TheKingOfChaos/RF-UPS-Monitor/docs/diagrams/README.md

# Diagrams

Excalidraw diagrams of the project. Each `.excalidraw` file opens and edits at [excalidraw.com](https://excalidraw.com) (Open, or drag the file in) or in VS Code with the Excalidraw extension; the `.svg` next to it is the exported picture used in the docs.

| Diagram | Shows | Used in |
|---|---|---|
| [system-overview](system-overview.svg) | Mains side, board (Pico, W5500, flash, button, LED), PC and network | README |
| [firmware-architecture](firmware-architecture.svg) | `src/`, the pure and hardware libraries in `lib/`, the Arduino-Pico core | README, project structure |
| [snmp-request-flow](snmp-request-flow.svg) | Size check, rate limiter, parsing, version and community checks, MIB, response, auth-failure trap | README, SNMP |
| [mains-flow](mains-flow.svg) | GPIO27 sampling and debouncing on core 1, seqlock, status/SNMP/traps on core 0, LibreNMS; the reset button path | README, mains monitoring |
| [settings-storage](settings-storage.svg) | Saving to the A/B slots and choosing a copy at boot | README, settings storage |
| [test-layers](test-layers.svg) | Native, sanitizer, net-snmp, on-device, HIL, mains and LibreNMS tests, and what CI runs | docs/TESTING.md |
| [web-request-flow](web-request-flow.svg) | Web page: request reading, login and lockout, sessions, CSRF check, validation, save | README, web page |
| [network-addresses](network-addresses.svg) | Where the IPv4 and IPv6 addresses, the IPv6 gateway and the trap destination come from | README, IPv6 |

## Changing a diagram

The `.excalidraw` files are generated by [make_diagrams.py](make_diagrams.py), which places the boxes and binds the arrows to them. Either edit the script and regenerate, or edit a file in Excalidraw; regenerating overwrites hand edits, so pick one.

```powershell
python docs/diagrams/make_diagrams.py                 # .excalidraw files
wsl -d Ubuntu-24.04 -- bash docs/diagrams/render_svg.sh   # .svg files (needs Docker and internet)
```

`render_svg.sh` runs [render.mjs](render.mjs) in the Playwright Docker image: headless Chromium loads Excalidraw 0.17.6 and exports each file with Excalidraw's own `exportToSvg`, then the hand-drawn Virgil font is embedded so the SVGs look the same on GitHub. After editing a diagram in Excalidraw, run only `render_svg.sh`, or export the SVG from Excalidraw yourself (Export image → SVG, with "Embed scene" off).
