TheKingOfChaos/RF-UPS-Monitor/hardware/pico-poe-mains-carrier/images/bottom.png

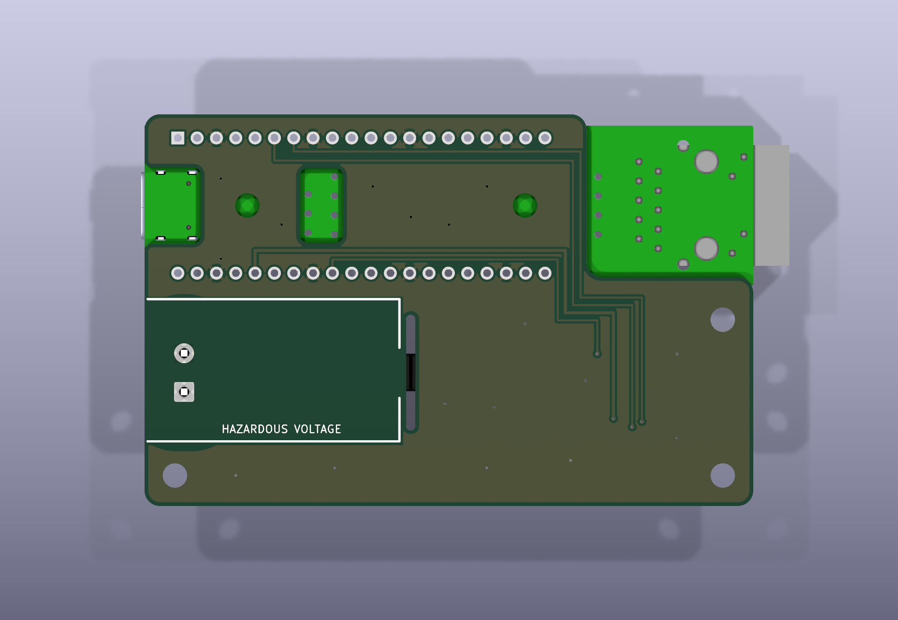
hardware/pico-poe-mains-carrier/images/bottom.png
