TheKingOfChaos/RF-UPS-Monitor/hardware/pico-poe-mains-carrier/images/iso-back-headers.png

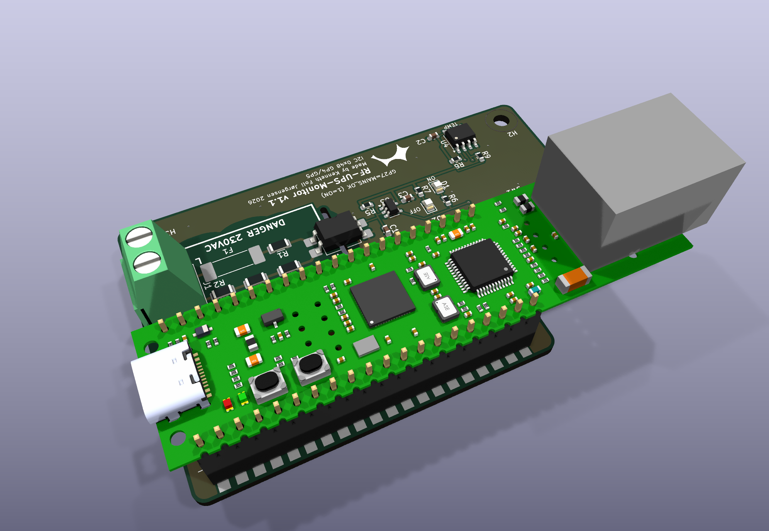
hardware/pico-poe-mains-carrier/images/iso-back-headers.png
