TheKingOfChaos/RF-UPS-Monitor/hardware/pico-poe-mains-carrier/images/top-carrier-only.png

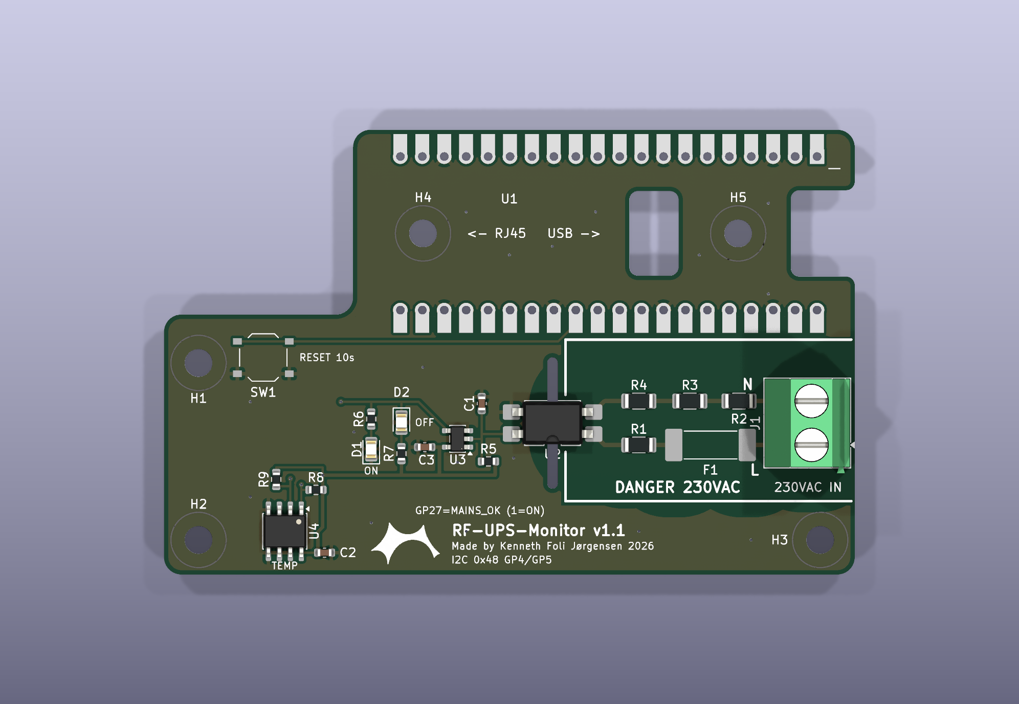
hardware/pico-poe-mains-carrier/images/top-carrier-only.png
