TheKingOfChaos/RF-UPS-Monitor/hardware/pico-poe-mains-carrier/images/top.png

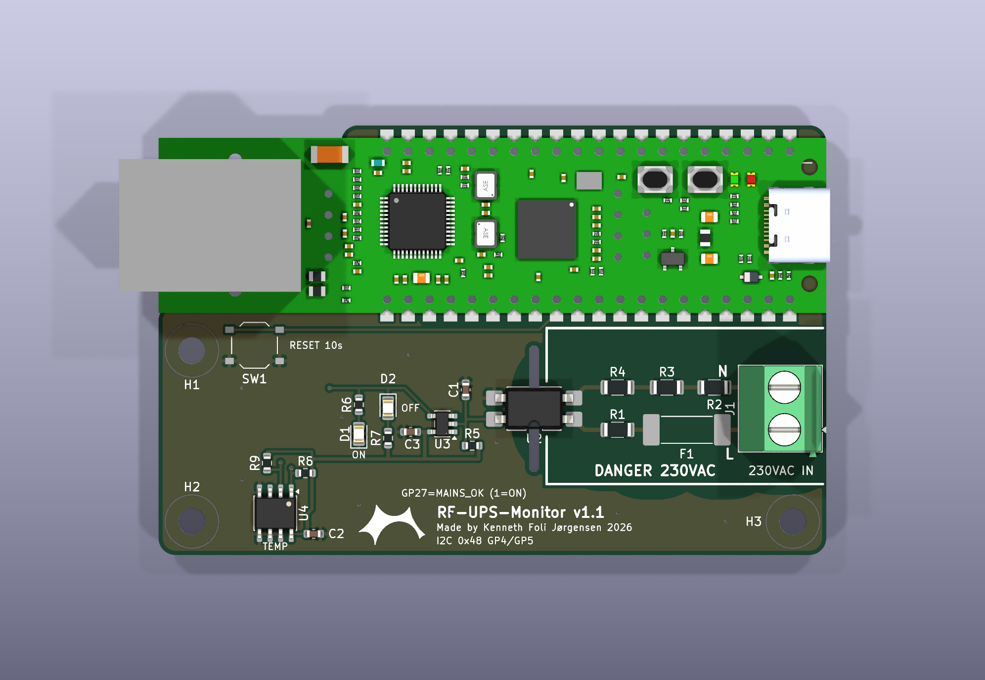
hardware/pico-poe-mains-carrier/images/top.png
