TheKingOfChaos/RF-UPS-Monitor/hardware/pico-poe-mains-carrier/fab/pico-poe-mains-carrier-bom.csv

Designator | Comment | Footprint | LCSC Part # | MPN | Quantity
C1 | 1uF | Capacitor_SMD:C_0603_1608Metric | C15849 |  | 1
C2,C3 | 100nF | Capacitor_SMD:C_0603_1608Metric | C14663 |  | 2
D1 | Green | LED_SMD:LED_0805_2012Metric | C2297 |  | 1
D2 | Red | LED_SMD:LED_0805_2012Metric | C84256 |  | 1
F1 | T100mA 250VAC | Fuse:Fuse_Schurter_UMT250 |  | Schurter 3403.0156.11 (UMT 250, T 100 mA, 250 VAC) | 1
J1 | 230VAC L/N | TerminalBlock_Phoenix:TerminalBlock_Phoenix_MKDS-1,5-2-5.08_1x02_P5.08mm_Horizontal |  | Phoenix 1715721 (MKDS 1,5/2-5,08) | 1
R1-R4 | 68k 1206 200V | Resistor_SMD:R_1206_3216Metric | C2889820 |  | 4
R5 | 47k | Resistor_SMD:R_0603_1608Metric | C25819 |  | 1
R6 | 100R | Resistor_SMD:R_0603_1608Metric | C22775 |  | 1
R7 | 330R | Resistor_SMD:R_0603_1608Metric | C23138 |  | 1
R8,R9 | 4.7k | Resistor_SMD:R_0603_1608Metric | C23162 |  | 2
SW1 | FACTORY RESET | Button_Switch_SMD:SW_Push_1P1T_XKB_TS-1187A | C318884 | XKB TS-1187A-B-A-B | 1
U2 | LTV-814S | Package_DIP:SMDIP-4_W9.53mm | C125118 | LTV-814S-TA1 | 1
U3 | SN74LVC1G14DBVR | Package_TO_SOT_SMD:SOT-23-5 | C7835 |  | 1
U4 | TMP1075DR | Package_SO:SOIC-8_3.9x4.9mm_P1.27mm | C2878381 |  | 1
