TheKingOfChaos/RF-UPS-Monitor/hardware/pico-poe-mains-carrier/fab/pico-poe-mains-carrier.step

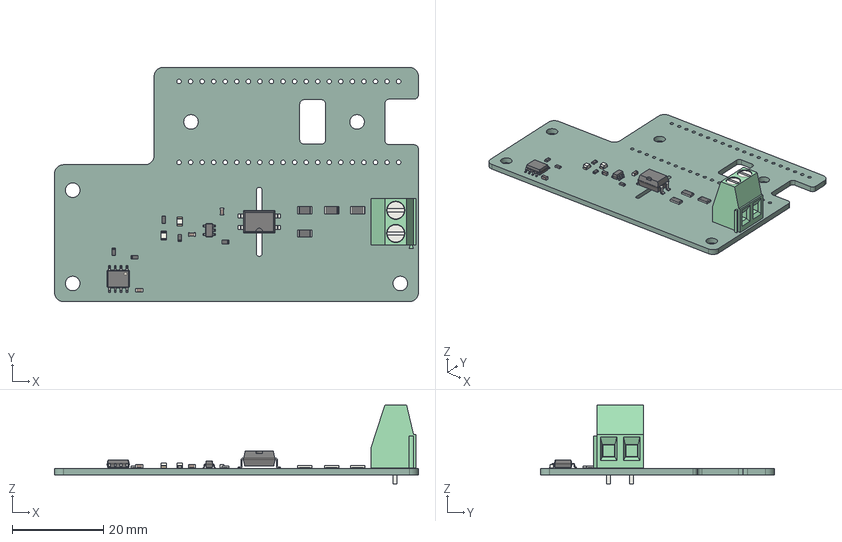
[picture p12: CAD file, 2026-10-18]
hardware/pico-poe-mains-carrier/fab/pico-poe-mains-carrier.step
80.0 x 51.5 x 17.3 mm
SMDIP_4_W953mm
SOT-23-5
LED_0805_2012Metric x 2
R_1206_3216Metric x 4
C_0603_1608Metric x 3
SOIC-8_3.9x4.9mm_P1.27mm
R_0603_1608Metric x 5
TerminalBlock_Phoenix_MKDS-1,5-2-5.08_1x02_P5.08mm_Horizontal
pico-poe-mains-carrier_PCB
