TheKingOfChaos/RF-UPS-Monitor/hardware/pico-poe-mains-carrier/3d/W5500-EVB-Pico-PoE_V1.1.step

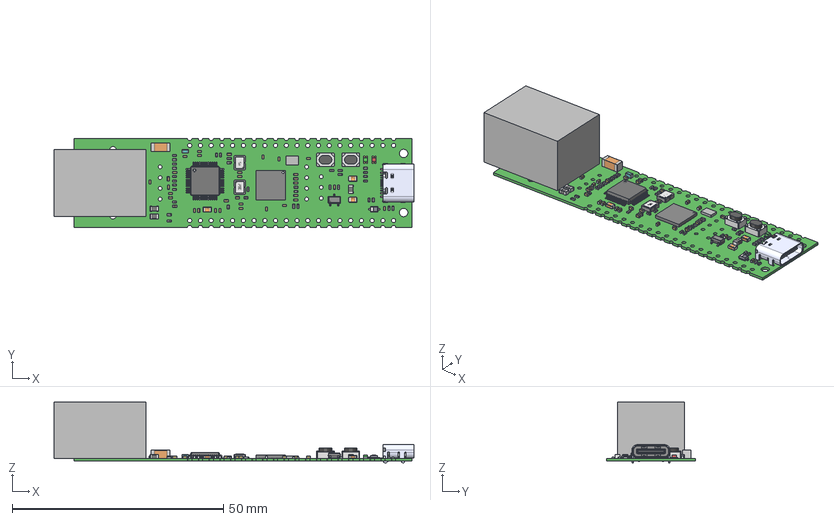
[picture p14: CAD file, 2026-10-18]
hardware/pico-poe-mains-carrier/3d/W5500-EVB-Pico-PoE_V1.1.step
85.2 x 21.0 x 14.3 mm
CAPC1005X06 x 33
RES_C1005X04N x 35
User_Library-QFN56_0_4
User_Library-ABRACON_ASE x 2
Extruded x 14
TYPE-C-31-M-12
User_Library-lqfp48-1
User_Library-LTST-C190GKT_Pad005
User_Library-LTST-C190GKT_Pad001
User_Library-LTST-C190GKT_Pad004
User_Library-LTST-C190GKT_Pad003
User_Library-LTST-C190GKT_Lens
User_Library-LTST-C190GKT_Pad
User_Library-LTST-C190EKT_Pad
User_Library-LTST-C190EKT_Pad005
User_Library-LTST-C190EKT_Pad001
User_Library-LTST-C190EKT_Pad004
User_Library-LTST-C190EKT_Pad003
User_Library-LTST-C190EKT_Lens
User_Library-Chip_InductorINDC1608X95N
SW3dPS-SOD-323F_Board5
SW3dPS-SOD-323F_Extruded9 x 2
SW3dPS-SOD-323F_Board4 x 2
SW3dPS-SOD-323F_Extruded8 x 2
SW3dPS-SOD-323F_Extruded10 x 2
SW3dPS-SOD-323F_Board3 x 2
SW3dPS-SOD-323F_Extruded7
SW3dPS-SOD-323F_Extruded6
SW3dPS-SOD-323F_Extruded11
0805_SMD_Capacitor x 3
User_Library-Chip_Cap_MLCC_1808_(4520)_K
