TheKingOfChaos/RF-UPS-Monitor/docs/TESTING.md

# Testing

The project has three test layers. Each one tests what the layer below cannot.

| Layer | Folder | Runs on | Framework | Command | Time |
|---|---|---|---|---|---|
| Unit | `test/native/` | Your PC | Unity | `pio test -e native` | ~5 s |
| On-device | `test/embedded/` | The Pico | Unity | `pio test -e pico` | ~35 s |
| Hardware-in-the-loop (HIL) | `test/hil/` | PC talking to flashed Pico | Python `unittest` | see below | ~20 s |

The rules for writing tests are in [.clinerules](../.clinerules), section *Testing Requirements → Test Rules*.

Test layers: from native unit tests to LibreNMS with real mains, and what CI runs

## CI

[.github/workflows/tests.yml](../.github/workflows/tests.yml) runs on every push and pull request on GitHub: the native unit tests, the same tests under AddressSanitizer/UBSan, the SNMP agent against net-snmp (`scripts/host_agent_check.sh`, including MIB validation), and a firmware build that uploads `firmware.uf2` as an artifact. It also compiles the on-device test programs. The on-device and HIL tests need the Pico and are run locally.

## One-time setup

### Host compiler (for `native`)

The native tests need `g++` on `PATH`. On Windows, install MinGW-w64 (WinLibs):

```powershell
winget install --id BrechtSanders.WinLibs.POSIX.UCRT -e
```

Restart VS Code (or open a new terminal) afterwards so `PATH` is refreshed, then check with `g++ --version`.

### USB driver (for flashing)

`pio run -t upload` and `pio test -e pico` use picotool, which needs the WinUSB driver on the Pico's boot interface. Do this once per PC:

1. Hold BOOTSEL while plugging in the Pico (the `RPI-RP2` drive appears).
2. Run [Zadig](https://zadig.akeo.ie), **Options → List All Devices**.
3. Select **RP2 Boot (Interface 1)** (USB ID `2E8A 0003 01`). Do not pick Interface 0, that is the drive.
4. Target driver **WinUSB**, click **Install Driver**, then replug.

### Serial port

The Pico is expected on `COM16` (set in `platformio.ini`; the HIL tests read `RFUPS_PORT`). Close PuTTY or any serial monitor first: an open port gives "Access denied" and the upload fails.

## Running the tests

`pio` is not on `PATH` by default. Use the full path, or the PlatformIO terminal / Testing panel in VS Code.

```powershell
$pio = "$env:USERPROFILE\.platformio\penv\Scripts\pio.exe"

# Unit tests on the PC, no hardware needed
& $pio test -e native

# On-device tests: flashes each test program to the Pico in turn
& $pio test -e pico

# One suite only
& $pio test -e native -f native/test_netconfig
& $pio test -e pico   -f embedded/test_settings_store
```

### Sanitizers (memory safety)

Code that parses data from the network must be free of out-of-bounds reads and undefined behaviour. MinGW has no sanitizers, so the native suites are also built with gcc in WSL using AddressSanitizer and UndefinedBehaviorSanitizer:

```powershell
& $pio test -e native     # once, downloads Unity and ArduinoJson
wsl -d Ubuntu-24.04 -- bash scripts/sanitize.sh
```

Every native suite must be listed in `scripts/sanitize.sh`; the script fails if one is missing.

### SNMP agent against net-snmp, without hardware

`scripts/host_agent_check.sh` builds the SNMP agent libraries into a small UDP server (`test/host/host_agent.cpp`, with ASan/UBSan), runs it on 127.0.0.1 in WSL and checks the output of the real `snmpget`, `snmpgetnext`, `snmpwalk`, `snmpbulkget`, `snmpbulkwalk` and `snmpset`, in v1 and v2c, and that v3 gets no reply. Use it after changing `lib/snmp_ber` or `lib/snmp_agent`, before flashing:

```powershell
wsl -d Ubuntu-24.04 -- bash scripts/host_agent_check.sh
```

It needs the `snmp` package in WSL. If `snmp-mibs-downloader` is installed too (it is on this PC), it also validates `mibs/RF-UPS-MONITOR-MIB.txt`: `snmptranslate -PW` must report no warnings in our file, every object must be in the tree, and `snmpget` must show MIB names (`mainsPowerStatus.0 = INTEGER: present(1)`). Without that package the MIB checks are skipped.

### HIL tests

These run against the real firmware, so flash it first:

```powershell
& $pio run -e pico -t upload
& "$env:USERPROFILE\.platformio\penv\Scripts\python.exe" -m unittest discover -s test/hil -v
```

They use the Python and `pyserial` that come with PlatformIO, so there is nothing to install. The SNMP tests (`test_snmp.py`) also call net-snmp in WSL (`wsl -d Ubuntu-24.04 -- snmpget ...`) and send raw UDP from Windows; they read the device IP from the serial status screen. Run one file with `-p`:

```powershell
& "$env:USERPROFILE\.platformio\penv\Scripts\python.exe" -m unittest discover -s test/hil -p "test_snmp.py" -v
```

The device must be in DHCP mode when the run starts, and is left in DHCP mode. The menu is available before the network is up, so tests that need the network call `Device.wait_connected()` first. The static IP test is skipped unless you give it a free address:

```powershell
$env:RFUPS_STATIC_IP = "10.10.6.250"   # must not be in use on the LAN
$env:RFUPS_STATIC_MASK = "255.255.0.0" # optional, default 255.255.0.0
$env:RFUPS_STATIC_GW = "10.10.0.1"     # optional, default: current DHCP gateway
$env:RFUPS_MANUAL_MAINS = "1"          # optional, mains off/on tests where you switch mains when asked
$env:RFUPS_MANUAL_BUTTON = "1"         # optional, interactive factory reset button test
$env:RFUPS_DHCP_TRAP_TARGET = "10.10.6.65" # optional: the address your DHCP server sends in option 224
$env:RFUPS_STATIC_IPV6 = "fd16:d833:4f0e:3ece::249" # optional: free address in the device's /64 (static IPv6 test)
$env:RFUPS_STATIC_IPV6_GATEWAY = "fe80::1"         # optional: gateway for that test (stored and shown only)
```

### Mains tests with a smart plug

The mains tests switch the device's mains input off and on. They run automatically when the mains detection circuit is fed from an outlet on an IKEA Dirigera hub ([test/hil/mains_switch.py](../test/hil/mains_switch.py)):

```powershell
$env:RFUPS_MAINS_SWITCH = "dirigera"
$env:RFUPS_DIRIGERA_IP = "10.10.6.124"        # the hub
$env:RFUPS_DIRIGERA_OUTLET = "Stikprop 1"     # outlet name in the IKEA app
# optional, paths on the WSL side, these are the defaults:
$env:RFUPS_DIRIGERA_TOKEN = "~/dirigera/token"
$env:RFUPS_DIRIGERA_PYTHON = "~/dirigera/.venv/bin/python"
```

One-time setup in WSL: `python3 -m venv ~/dirigera/.venv && ~/dirigera/.venv/bin/pip install dirigera`, then `~/dirigera/.venv/bin/generate-token <hub ip>` (press the button on the hub) and save the token in `~/dirigera/token` with `chmod 600`. Never commit the token. The tests call [test/hil/dirigera_outlet.py](../test/hil/dirigera_outlet.py) with that Python and always switch the outlet back on, also when a test fails. One switch takes about a second; the device sees the change about 0.1 s after the hub confirms it.

Without `RFUPS_MAINS_SWITCH`, `RFUPS_MANUAL_MAINS=1` runs the same tests with prompts for you to switch mains by hand (except the short-outage test). With neither, they are skipped.

The trap tests (`test_snmp_traps.py`) set the device's trap destination to this PC and listen on UDP 162. Windows Firewall asks once whether PlatformIO's Python may receive network traffic; allow it on the network the Pico is on, or no traps arrive. The tests restore the previous trap destination.

Flashing an embedded test replaces the firmware, so always reflash with `pio run -e pico -t upload` before HIL tests or normal use.

## What is covered

### `test/native/test_netconfig`: `lib/netconfig`
- IPv4 parsing: valid addresses, octet range, octet count, stray characters, signs, whitespace, empty and null input, output left untouched on failure
- Subnet masks: every prefix /1 to /32 accepted, zero and non-contiguous masks rejected
- Static configuration: first failing field reported, network/broadcast host rejected, /31 and /32 handled, gateway outside the subnet or equal to the host rejected
- IPv6 parsing: full and compressed forms, `::` at start/middle/end and for one group, upper case, the 39-character maximum; malformed text (`:::`, two `::`, 7 or 9 groups, 5-digit groups, `/64`, `%zone`, IPv4 tails, spaces, 40 characters) refused with the output untouched; every truncation of an address
- IPv6 formatting (RFC 5952): longest zero run as `::`, first run on a tie, single zero group kept, lower case
- Static IPv6: empty = none, gateway without address refused; ::/8, link-local, multicast and zero interface id refused; gateway must be unicast, link-local or in the /64, and differ from the address

### Hostnames in `test/native/test_netconfig`
- Hostname rules (length 1-32, letters/digits/'-', no leading or trailing '-', one label, ASCII only)
- Free text to hostname: valid names unchanged, runs of other characters become one '-', cut at 32 on a word end, fallback name; every printable text gives a valid hostname

### `test/native/test_dhcp_option`: DHCP option 224 (`lib/dhcp_option`)
- Real frames: the device's own DISCOVER and REQUESTs (dumped at the driver), the LAN server's OFFER/ACK, and Kea 2.2.0's replies to the device's frames replayed in Docker with and without option 224 added (`frames.h`). Kea sent 224 only to the edited frames, which proves the request works
- Editing: 224 appended to option 55 in every device request, length unchanged, nothing else changed, UDP checksum recomputed (not dropped), idempotent, zero checksum kept, no padding = no change, server messages / ARP / corrupt frames untouched, every truncation and every single-byte corruption safe
- (see also `test_access_control`: IPv4 key = address, IPv6 key = full address, IPv4-mapped = IPv4, ::/32 refused, hosts in one /64 have their own buckets and a manager's trust does not pass to its /64 neighbours, RFC 5952 log formatting)
- Reading: Kea ACK gives 10.10.6.65, the lease, the transaction id of the device's request and the server id, ACKs without 224, OFFERs and requests are not ACKs, another MAC, wrong option length, bad IP/UDP checksums, fragments, every truncation and corruption

### `test/native/test_settings_codec`: `lib/settings_codec`
- Defaults and JSON round trip, maximum-length fields fit the buffer
- v1 files without `sequence` still load (backward compatibility)
- Rejection of empty, malformed, wrong-version, mistyped, over-long and unprintable data, with no truncation
- Static configuration is validated only when DHCP is off
- Sequence comparison across 32-bit wrap-around, A/B slot selection, and fallback when the newer copy is invalid
- sysName/sysContact/sysLocation: defaults, round trip with characters JSON escapes, worst-case size fits, older files load with defaults, over-long/non-printable/mistyped values rejected, empty allowed; `settingsTextIsValid` boundaries
- Static IPv6: empty by default and for files without the fields, round trip and equality, works with DHCP for IPv4, invalid/over-long/mistyped values rejected

### `test/native/test_snmp_ber`: `lib/snmp_ber`
- OID text parsing and formatting, X.690 rules for the first two arcs, 32-bit arcs, arc limit
- Lexicographic OID ordering (numeric, prefix first) and prefix matching, for GetNext
- Minimal encodings of INTEGER (sign boundaries, INT32_MIN/MAX), Counter32/Gauge32/TimeTicks (leading 0x00), OCTET STRING, NULL, OID, IpAddress
- Short and long form lengths, nested sequences growing past 127 bytes, buffer-full and nesting errors
- Byte-exact encode and decode of requests captured from net-snmp (`snmpget`, two varbinds)
- Strict decoding: truncation at every length, lengths beyond the buffer, indefinite/oversized lengths, multi-byte tags, wrong tags, bad INTEGER/unsigned/NULL/OID encodings, child readers confined to their region, sticky errors
- Every single-byte corruption of a real request (~15 000 packets) decodes safely; run `scripts/sanitize.sh` to check this under AddressSanitizer
- Counter64: minimal encoding from 0 to 2^64-1 (leading 0x00 when the top bit is set), round trip, oversized values rejected

### `test/native/test_snmp_message`: `lib/snmp_agent` message layer
- net-snmp Get, GetNext and two-varbind requests parsed exactly; SetRequest accepted for the agent to reject
- v2c/v3 → BadVersion, response/trap/unknown PDUs → UnsupportedPdu, trailing bytes, every truncation, varbind without value, garbage → Malformed
- Varbind limit (16), empty varbind list
- GetResponse byte-exact; every value type; unknown value type and full buffer fail cleanly
- Error responses echo the request varbinds byte for byte; community preserved byte for byte
- Every single-byte corruption of a real request parses safely

### `test/native/test_snmp_agent`: MIB and request handling
- MIB strictly sorted, expected objects, exact match and next-object lookup (non-leaf and between objects)
- GetRequest of every object with type and value from the device state; mains lost; empty strings
- noSuchName with the right error-index for unknown and non-leaf OIDs
- Full walk from `1.3` visits every object in order and ends with noSuchName; enterprise subtree; several GetNext varbinds
- SetRequest → noSuchName with the value echoed
- No response for wrong community (several near-misses), changed community, v2c/v3, response PDUs, malformed packets
- tooBig when the response does not fit, nothing when even the error does not fit, 16 varbinds fit
- Statistics, request id echo across the int32 range, every single-byte corruption yields either nothing or a valid response

### v2c in the native suites
- `test_snmp_message`: net-snmp v2c Get and GetBulk parsed (non-repeaters/max-repetitions), GetBulk refused in v1, Inform/v2-Trap/Report refused, v2c response byte-exact with an exception value, `tryAdd` rollback, every single-byte corruption of a GetBulk request
- `test_snmp_agent`: v2c Get with noSuchObject/noSuchInstance and no error-status, GetNext endOfMibView, full v2c walk, Set notWritable/noCreation, v1 unchanged for the same requests; GetBulk against the net-snmp request, interleaved repeaters, whole MIB in one request, zero/negative/oversized parameters, INT32_MAX repetitions bounded, truncation, tooBig only when nothing fits, v2c tooBig with empty list, corruption
- `test_snmp_trap`: v2c coldStart and mainsPowerLost byte-exact against `snmptrap -v2c`, trap OIDs for all four traps
- `test_settings_codec`: trap version default v2c, round trip, invalid values rejected

### IF-MIB and board temperature in the native suites
- `test_if_stats` (`lib/if_stats`): frame classification (unicast, multicast, broadcast, runt frames), receive verdicts (IPv4/ARP delivered, IPv6 only when enabled, other EtherTypes unknown, length boundaries 13/14/1514/1515), each received frame in exactly one counter, discards, octet and packet counting, 64-bit counters past 2^32, W5500 PHYCFGR decoding (link, 10/100, duplex) and speed in bit/s
- `test_snmp_agent`: ifTable and ifXTable values from the device state, ifInDiscards/ifInErrors/ifInUnknownProtos, ifPhysAddress is the MAC, Counter64 values, link down shows `down` and speed 0, no such instance for interface 2, Counter64 objects do not exist for v1 (Get and walk, RFC 3584), a v1 walk returns every other object, board temperature
- `test_snmp_agent` GetBulk: a walk returns the whole MIB then endOfMibView, replies are capped at 16 varbinds (no amplification), a GetBulk does not make its source trusted

### `test/native/test_web_ui`: the web page (`lib/web_ui`)
- SHA-256 against the NIST vectors (incl. one million 'a'), split at every position around the padding boundaries
- Password rules, salted iterated hash compared with an independent Python `hashlib` result, the stepwise check equals the one-shot check for every step size and always runs all rounds, wrong/malformed hashes never match, default password alphabet, constant-time compare
- Sessions: token format, idle expiry, millis wrap, replacement of the least recently used, logout/clear; login throttle: lockout after 5 failures for 30 s, reset on success, wrap
- HTTP parser: GET/POST, every prefix incomplete, byte-by-byte, header lookup, size limits at the boundary, malformed request lines, chunked, NUL bytes, extra bytes; form and cookie decoding; HTML escaping
- Stylesheet: served without login with gzip and year-long caching headers, body straight from flash; the embedded data is a gzip file whose trailer matches the CSS size; pages link it; the policy allows it and still no scripts; mains and link badges follow the state
- Page logic with a fake backend: login form, right/wrong login, lockout, status values escaped, every action needs session and CSRF token, community, network and IPv6 validation (IPv6 stored in short form, empty removes it), save failure, reboot, logout, idle expiry, 404/405/400/413, security headers and Content-Length on every response, every single-byte corruption of two real requests gives a well-formed response

### `test/native/test_snmp_trap`: trap encoding
- mainsPowerLost and coldStart byte-for-byte identical to net-snmp's `snmptrap` output for the same fields; authenticationFailure differs only in generic-trap
- mainsPowerRestored fields, varbinds are the MIB objects with the right types, configured community used
- Failure on small buffers, missing community, too many varbinds
- Throttle: one per interval, first event at time 0, millis() wrap-around

### `test/native/test_access_control`: rate limiter and access log
- Burst then refusal, refill at the configured rate, refill capped at the burst, sustained rate over 10 s within 2 requests of the theory
- Independent per-source buckets; full table evicts the least recently seen source; wrap-around; an idle gap of more than 2^31 ms refills instead of freezing
- Global bucket: a new source address on every request is capped at global burst + rate; a source refused by its own bucket does not drain the global one; a single source is still limited by its own bucket; off by default
- Trusted sources: not starved when spoofed sources drain the global bucket, not evicted by thousands of rotating sources, untrusted entries evicted first; marking an unknown source is ignored
- Trust is bounded: trusted sources together capped by their own shared bucket, at most `maxTrusted` trusted (a freed slot can be reused), trust expires after inactivity even for sources that never send again (their slots and eviction protection are released), `clearTrust()` revokes all; default without `configureTrusted()` unchanged
- Log newest-first, folding of repeats with first/last time and count, new entry on a different source or event, ring buffer keeps the newest 16, clamped index
- Event names, IPv4 formatting

### `test/native/test_reset_button`: factory reset button logic
- Idle button: no events, LED off
- 10 s hold triggers exactly once, counted from the debounced press, within DEBOUNCE_MS of the physical press
- Short press and release 1 ms before the hold time do not trigger (raw level is checked, not only the debounced one)
- Contact bounce filtered; button held at boot must be released before it can trigger
- LED pattern: slow blink while held, fast after trigger, also after release
- millis() wrap-around, configurable hold time

### `test/native/test_power_debouncer`: `lib/power_monitor`
- Initial state not counted as a change, stable input never changes
- Change accepted exactly after the debounce time, detection within the 10 ms requirement
- Glitches and contact bounce ignored, the timer restarts on every bounce
- Change counting, `millis()` wrap-around, delayed (sparse) samples

### `test/embedded/test_mains_input`: `lib/mains_input` on core 1
Works with or without the mains circuit connected.
- Core 1 publishes a snapshot and samples at about 1 kHz
- 200 000 reads from core 0 while core 1 writes: counters never go backwards
- Debounced state follows a stable pin
- Diagnostic (`-v`): raw toggle rate and duty cycle of GPIO27, to spot an unfiltered AC signal

### `test/embedded/test_settings_store`: `lib/settings` on LittleFS
Uses `test/settings_a.json` and `test/settings_b.json`, never the real settings.
- Save and reload, slot alternation, newest copy wins
- A half-written newest copy falls back to the previous one, and the next save overwrites the corrupt copy
- Both copies corrupt, or a file that is too large: defaults are used
- A v1 file is loaded and replaced by a newer copy
- Saving factory defaults (sequence 0) still beats the stored copy
- A maximum-size file (every text field at 63/31 characters, fully JSON-escaped) saves and reloads
- Files left by older firmware (`config.bak`, `config.schema.json`, `data/active_file`) are removed and the settings copies kept
- Stack use of save + load, measured by painting the stack: must stay within 1536 bytes (it was over 3 KB before the buffers were made static and -Os was restored, which crashed the device)

### `test/embedded/test_ethernet`: W5500 and lwIP
- W5500 detected over SPI, link up, DHCP lease with a gateway, gateway answers ping

### `test/hil/test_serial_menu.py`: the flashed firmware
- Menu text, status output with state, lease and MAC, ping from the PC
- Boot does not wait for DHCP: the prompt appears within 5 s, before `Network up`, and the lease still arrives
- Unknown input, backspace editing
- Each invalid entry rejected with one clear message; cancel leaves settings unchanged
- DHCP save → reboot → reconnect → ping
- Static IP applied after reboot, then DHCP restored (opt-in)
- Mains power line on the status screen
- SNMP settings on the status screen; option 4 rejects an empty or 32-character community, a 64-character sysName and a line longer than the input buffer; Enter keeps, `-` clears; cancel changes nothing
- Mains loss and restore reported in the log and status (needs a mains switch, see above)

### `test/hil/test_snmp.py`: the SNMP agent on the device
- `snmpget` of sysDescr, sysObjectID, several varbinds in order; sysUpTime advances ~100 ticks per second
- Mains objects present and consistent with the serial status screen
- `snmpwalk` of everything (45 objects in v1 in order, End of MIB; v1 does not see the eight Counter64 columns), the system group (7) and the enterprise subtree (4)
- IF-MIB: ifDescr, ifType, ifMtu, admin/oper status, ifName; ifSpeed, ifHighSpeed and ifPhysAddress match the status screen; 20 requests raise the 64-bit packet and octet counters; ifInOctets is the low half of ifHCInOctets; the receive drop counters match the status screen; Counter64 is noSuchName in v1
- boardTemperature between 10 and 85 °C and within 2 °C of the status screen
- noSuchName for unknown OIDs and past the end; `snmpset` rejected and nothing changed
- Wrong community and v2c get no reply and are counted on the status screen
- SNMP settings set from the menu show up in `snmpget` immediately (no reboot), the old community is refused, and they survive a reboot; the originals are restored afterwards
- Rate limit: requests as fast as replies come back for 3 s are answered at burst + 50/s (±15 %), the rest dropped, counted and logged; answers resume after a pause
- Access log lists bad community and bad version from this PC, newest first; SetRequests are logged
- The device must use community `public` for this suite

- v2c: get, exceptions instead of errors, walk of all 53 objects ending with endOfMibView, `snmpbulkwalk` returns the same objects as `snmpwalk`, `snmpbulkget -Cn1 -Cr3`, `-Cr1000` capped at 16 varbinds and reaching endOfMibView, Set notWritable, wrong community; SNMPv3 gets no reply and is counted; v1/v2c counters

### `test/hil/test_web.py`: the web page on the device
- Login form without device data, security headers; wrong password refused and logged; login shows the device status
- 5 failed logins lock out even the right password for 30 s, logged as `web locked out`
- Actions need session and CSRF token; community change applies to SNMP at once (old community refused) and is restored; invalid community and invalid static address rejected without restart
- Restart button and DHCP save restart the device (sysUpTime restarts, default password kept); static IP from the web page and back (opt-in `RFUPS_STATIC_IP`)
- Hostname from the web page: status screen, SNMP sysName and mDNS (`name.local` resolved by the PC) follow at once without restart; invalid names refused; restored afterwards
- Web interface off via serial option 8: port 80 closed, SNMP keeps working, off survives a restart, back on; the page turning itself off asks first, then closes port 80, and serial option 8 reopens it at once (the TIME-WAIT case)
- Logo and favicon: `/favicon.svg` is the path from `logo/RF-canopy-RGB-Orange.svg`, logo in the navbar and on the login card
- New default password via serial option 7: `n` changes nothing; `y` gives a new 10-character password, logs browsers out, refuses the old one and keeps the new one across a restart; an own password stays in use
- Own password via serial option 6: masked echo, old sessions logged out, default refused, hashed check under 2 s, mismatch and short passwords change nothing, `-` restores the default
- The Bootstrap stylesheet downloaded from the device unpacks to exactly Bootstrap 5.3.3 (official integrity hash), without slowing SNMP
- With an own password set, SNMP stays under 100 ms while a login (right or wrong) hashes the password
- A client that never finishes its request does not slow SNMP and is dropped after 5 s; 30 page loads keep SNMP under 100 ms and leave > 1 KB of core 0 stack never used; oversized request gets 413
- Needs the device default web password (the suite skips otherwise)

### `test/hil/test_ipv6.py`: IPv6 on the device
- Link-local address from the MAC (EUI-64), SLAAC address from the router's prefix (skipped without an IPv6 router), ping6
- SNMP get over IPv6, a wrong community over IPv6 logged with the PC's full address, web page at `http://[address]/`, `name.local` resolves to IPv6, IPv4 still answers
- Four requests sent back to back over IPv4 and over IPv6 are all answered (they crashed the device before `LWIP_IPV6_FRAG=0`)
- No restart during the run (sysUpTime keeps rising): the first IPv6 build panicked seconds after boot

### `test/hil/test_ipv6_static.py`: static IPv6 address
- Menu option 9 refuses link-local addresses, `/64` suffixes and gateways outside the /64, shows the address in short form, and `n` changes nothing
- Opt-in (`RFUPS_STATIC_IPV6`): the address is set, the device restarts, the address passes duplicate detection and is marked `(static)` while the link-local and SLAAC addresses stay; ping6, SNMP and the web page answer on it; then it is removed again
- The device must start without a static IPv6 address (the suite skips otherwise)

### `test/hil/test_dhcp_trap.py`: trap destination from DHCP
- Choosing `dhcp` asks for option 224 in the renewal, the LAN's server still answers (same lease and IP, SNMP answers), the status screen reports the ACK; back to fixed
- A forged DHCPACK with option 224 (Kea's capture re-addressed to the device, wrong transaction id) sent from this PC is ignored and counted
- Opt-in `RFUPS_DHCP_TRAP_TARGET=<address>`: with a server that sends option 224, the destination in use is that address; if it is this PC, an authenticationFailure trap arrives there

### `test/hil/test_snmp_traps.py`: traps on the device (every test runs with v1 and with v2c traps)
- coldStart arrives after a reboot (empty ARP table, the trap is the first packet to this PC), exactly once, from the device's address, with a small time-stamp
- A wrong community sends one authenticationFailure trap; five more within 10 s send none but are counted in the access log
- No traps when the destination is off; trap counter on the status screen; SNMP keeps answering
- mainsPowerLost and mainsPowerRestored with real mains: correct version, source, varbinds, change counter and time-stamps (needs a mains switch)

### `test/hil/test_factory_reset.py`: the reset button (manual, `RFUPS_MANUAL_BUTTON=1`)
- A ~3 s press is released without reset, and SNMP keeps answering while it is held
- A 10 s hold resets after 10000-10100 ms, defaults are saved in under 2 s, the device reboots with DHCP, `public`, default sysName, no trap destination and default stored static IP
- Your previous SNMP settings and stored static IP are restored afterwards
- 30 requests: every reply echoes its request id, worst case under 100 ms
- 300 malformed packets in bursts: agent keeps answering; oversized packet ignored; 5 simultaneous requests all answered
- Mains loss/restore over SNMP: status, change counter and last-change time; a ~1 s outage between two reads still shows as two changes in mainsPowerChanges (needs a mains switch)

## Adding a test

1. Decide the layer. If the code can run without the Pico, move it into a pure library under `lib/` and test it in `test/native/`. Use `test/embedded/` only for flash, SPI, GPIO or timing, and `test/hil/` for end-to-end behaviour.
2. Add the test to the matching suite, or create a new suite folder named `test_<area>` with a `test_main.cpp`:
   - native: `int main()` with `UNITY_BEGIN()`, `RUN_TEST(...)`, `return UNITY_END();`
   - embedded: the same inside `setup()`, after waiting up to 10 s for `Serial`, and an empty `loop()`
3. Name it `test_<what>_<expected behaviour>` and assert on the code under test.
4. Check it can fail: break the code briefly (or write the test before the fix) and watch it go red.
5. Run all native and embedded tests before committing.

## Diagnosing a hang or crash on the device

A firmware that freezes takes USB serial with it, so neither the menu nor `pio run -t upload` reach it (then: hold BOOTSEL while plugging in). The diagnosis build avoids that:

```powershell
$env:PLATFORMIO_BUILD_FLAGS = '-DRFUPS_DIAG -Wl,--wrap=panic'
& $pio run -e pico -t upload
Remove-Item Env:PLATFORMIO_BUILD_FLAGS
```

It arms the hardware watchdog (4 s), writes the step of `loop()` and of the frame hooks into watchdog scratch registers, records the program counter of a hard fault and the message of a `panic()` (lwIP asserts end there), and prints all of it after the watchdog restart: `DIAG: previous run PANICKED (called from 0x10025129): lwip`. Look the address up with `arm-none-eabi-addr2line -f -e .pio\build\pico\firmware.elf <address>`. This found the IPv6 timer-pool panic in `sys_timeout_abs` and the hard fault in `pbuf_free` caused by the core's UDP helper buffer.

## Troubleshooting

| Symptom | Cause and fix |
|---|---|
| `g++` not found / native build fails immediately | MinGW not installed or `PATH` not refreshed. Restart VS Code. |
| `could not open port 'COM16'` | Port in use (PuTTY, serial monitor) or Pico unplugged. |
| `No accessible RP2040 devices in BOOTSEL mode` | WinUSB driver missing on the boot interface, see Zadig above. |
| Embedded test hangs with no output | Board not running the test program. Press reset or replug. `scripts/wait_for_port.py` already waits for the port to come back after flashing. |
| `test_dhcp_lease_obtained` fails | No cable, no link LED, or no DHCP server on that network. |
| HIL tests skipped with "device is in Static mode" | Switch to DHCP with menu option 2 first. |
| Device stops answering on USB right after saving | Stack overflow on core 0 (8 KB since 2.3.0, 4 KB before). Run `test_settings_store` for the stack measurement, check no large buffer was put on the stack, and that `-Os` is not unflagged. Replug USB to recover. |
| A HIL run hangs and COM16 stays "Access denied" | The device hung and the test process is stuck in the USB driver; replug the Pico. |
| Trap tests: "no ... trap" although the status screen counts them as sent | Windows Firewall blocks inbound UDP for PlatformIO's Python; allow it (Public or Private profile, whichever the LAN is). |
| SNMP tests fail with timeouts right after the flood or rate-limit test | The rate limiter is still refilling; the tests wait 2.5 s, increase if your PC is slow. |
