TheKingOfChaos/RF-UPS-Monitor/hardware/pico-poe-mains-carrier/fab/pico-poe-mains-carrier-schematic.pdf

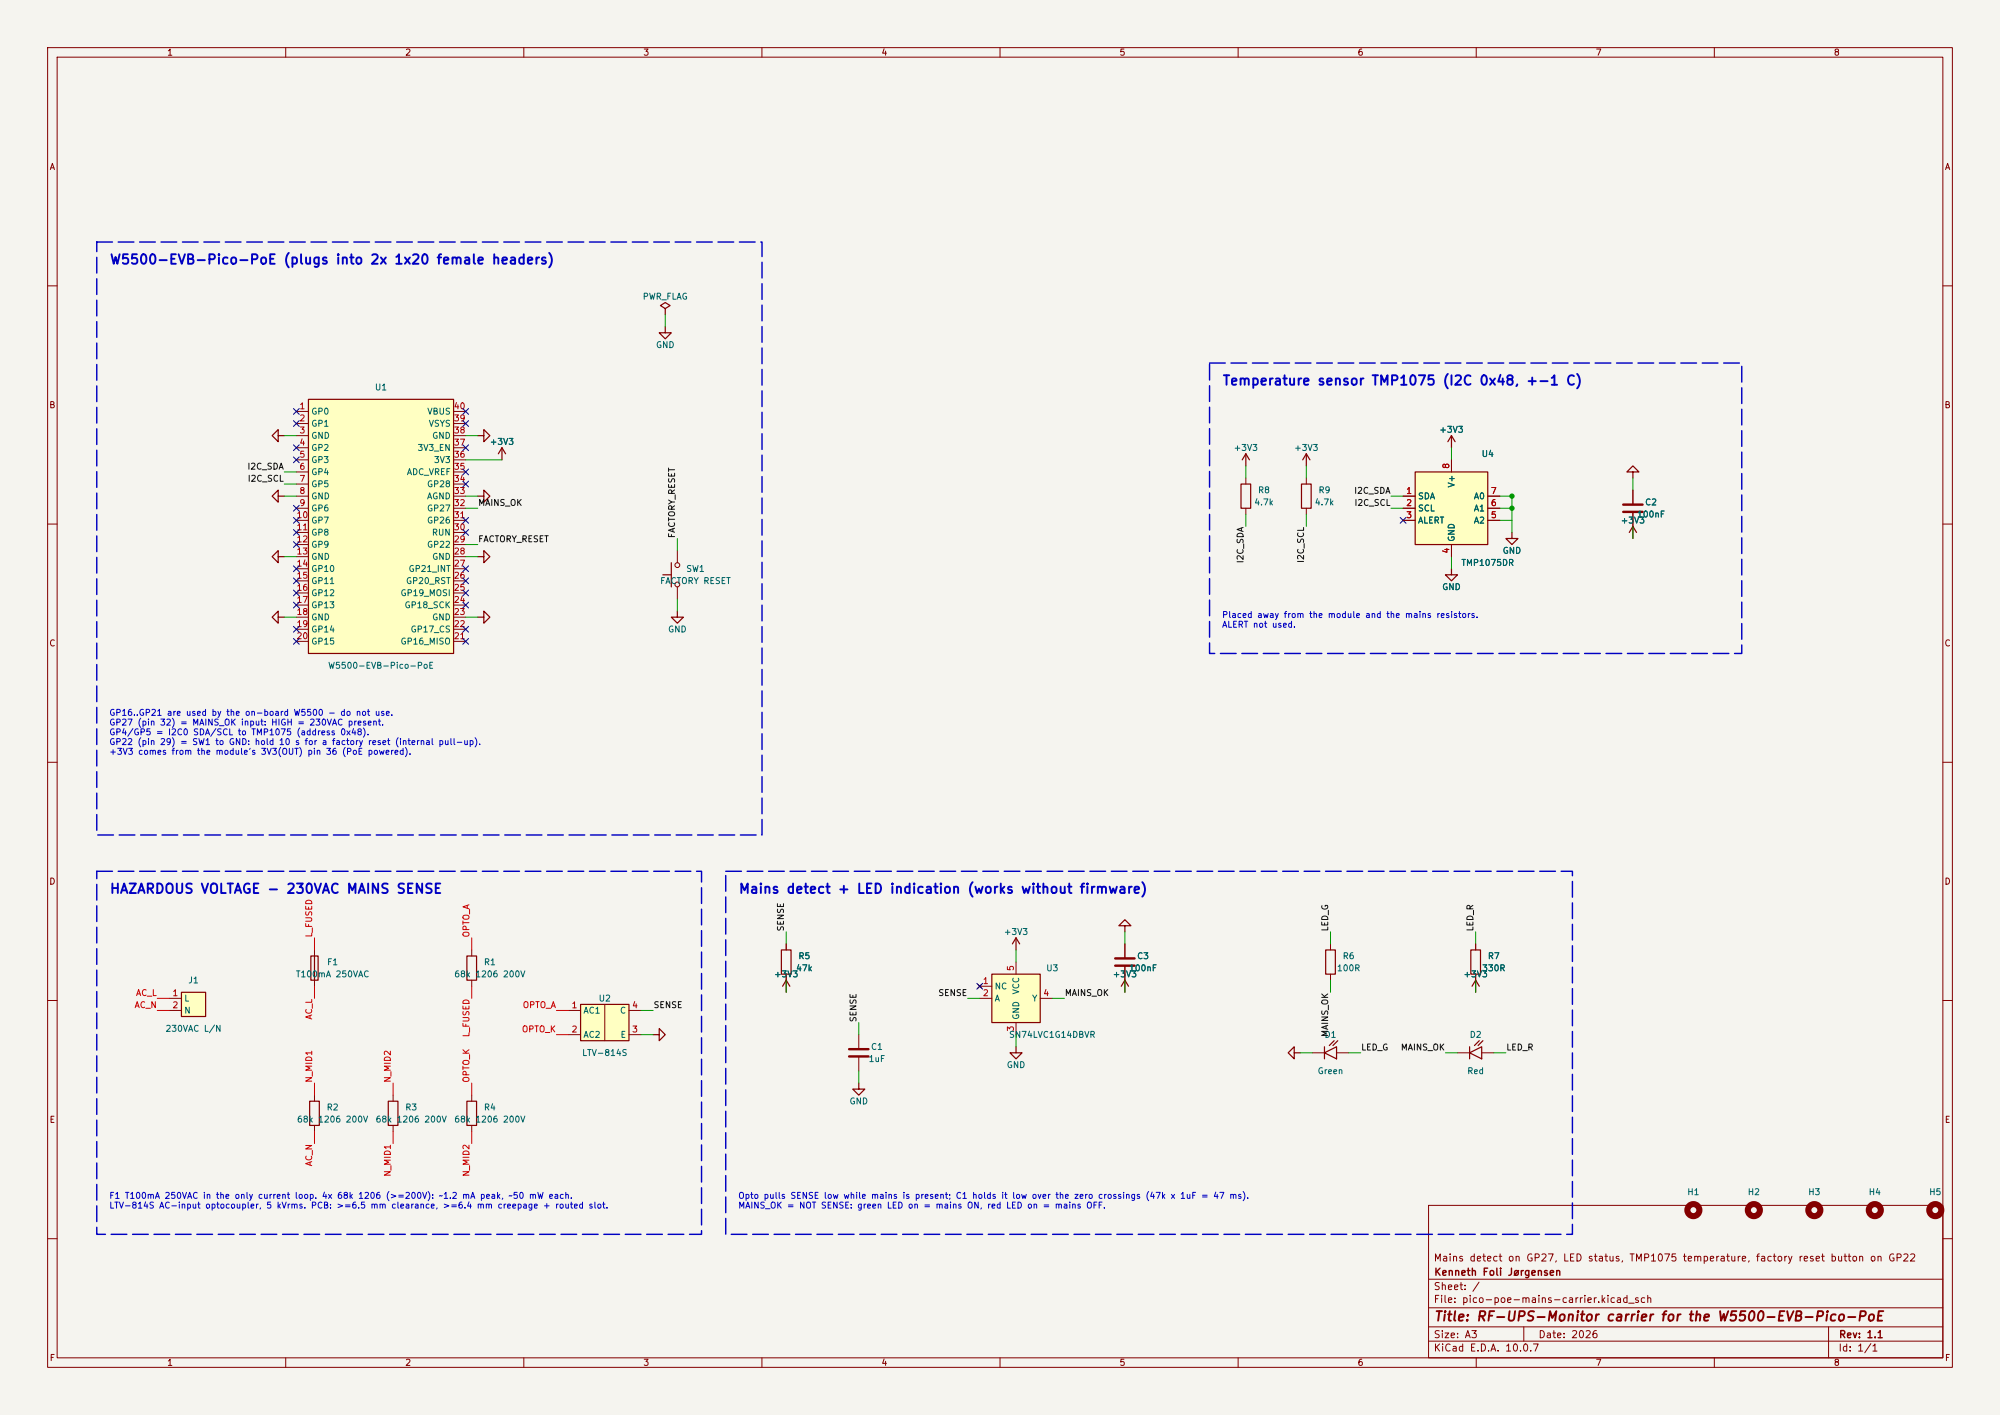
[picture p15: page 1]

W5500-EVB-Pico-PoE (plugs into 2x 1x20 female headers)

Placed away from the module and the mains resistors. ALERT not used. HAZARDOUS VOLTAGE - 230VAC MAINS SENSE

GP16..GP21 are used by the on-board W5500 - do not use. GP27 (pin 32) = MAINS_OK input: HIGH = 230VAC present.

Mains detect on GP27, LED status, TMP1075 temperature, factory reset button on GP22
Kenneth Foli Jørgensen
Sheet: /
File: pico-poe-mains-carrier.kicad_sch
Title: RF-UPS-Monitor carrier for the W5500-EVB-Pico-PoE

Size: A3 | Rev: 1.1 | F Date: 2026
KiCad E.D.A. 10.0.7 | Id: 1/1
