TheKingOfChaos/RF-UPS-Monitor/hardware/pico-poe-mains-carrier/pico-poe-mains-carrier.kicad_pcb

## KiCad design hardware/pico-poe-mains-carrier/pico-poe-mains-carrier.kicad_pcb (2026-10-18)

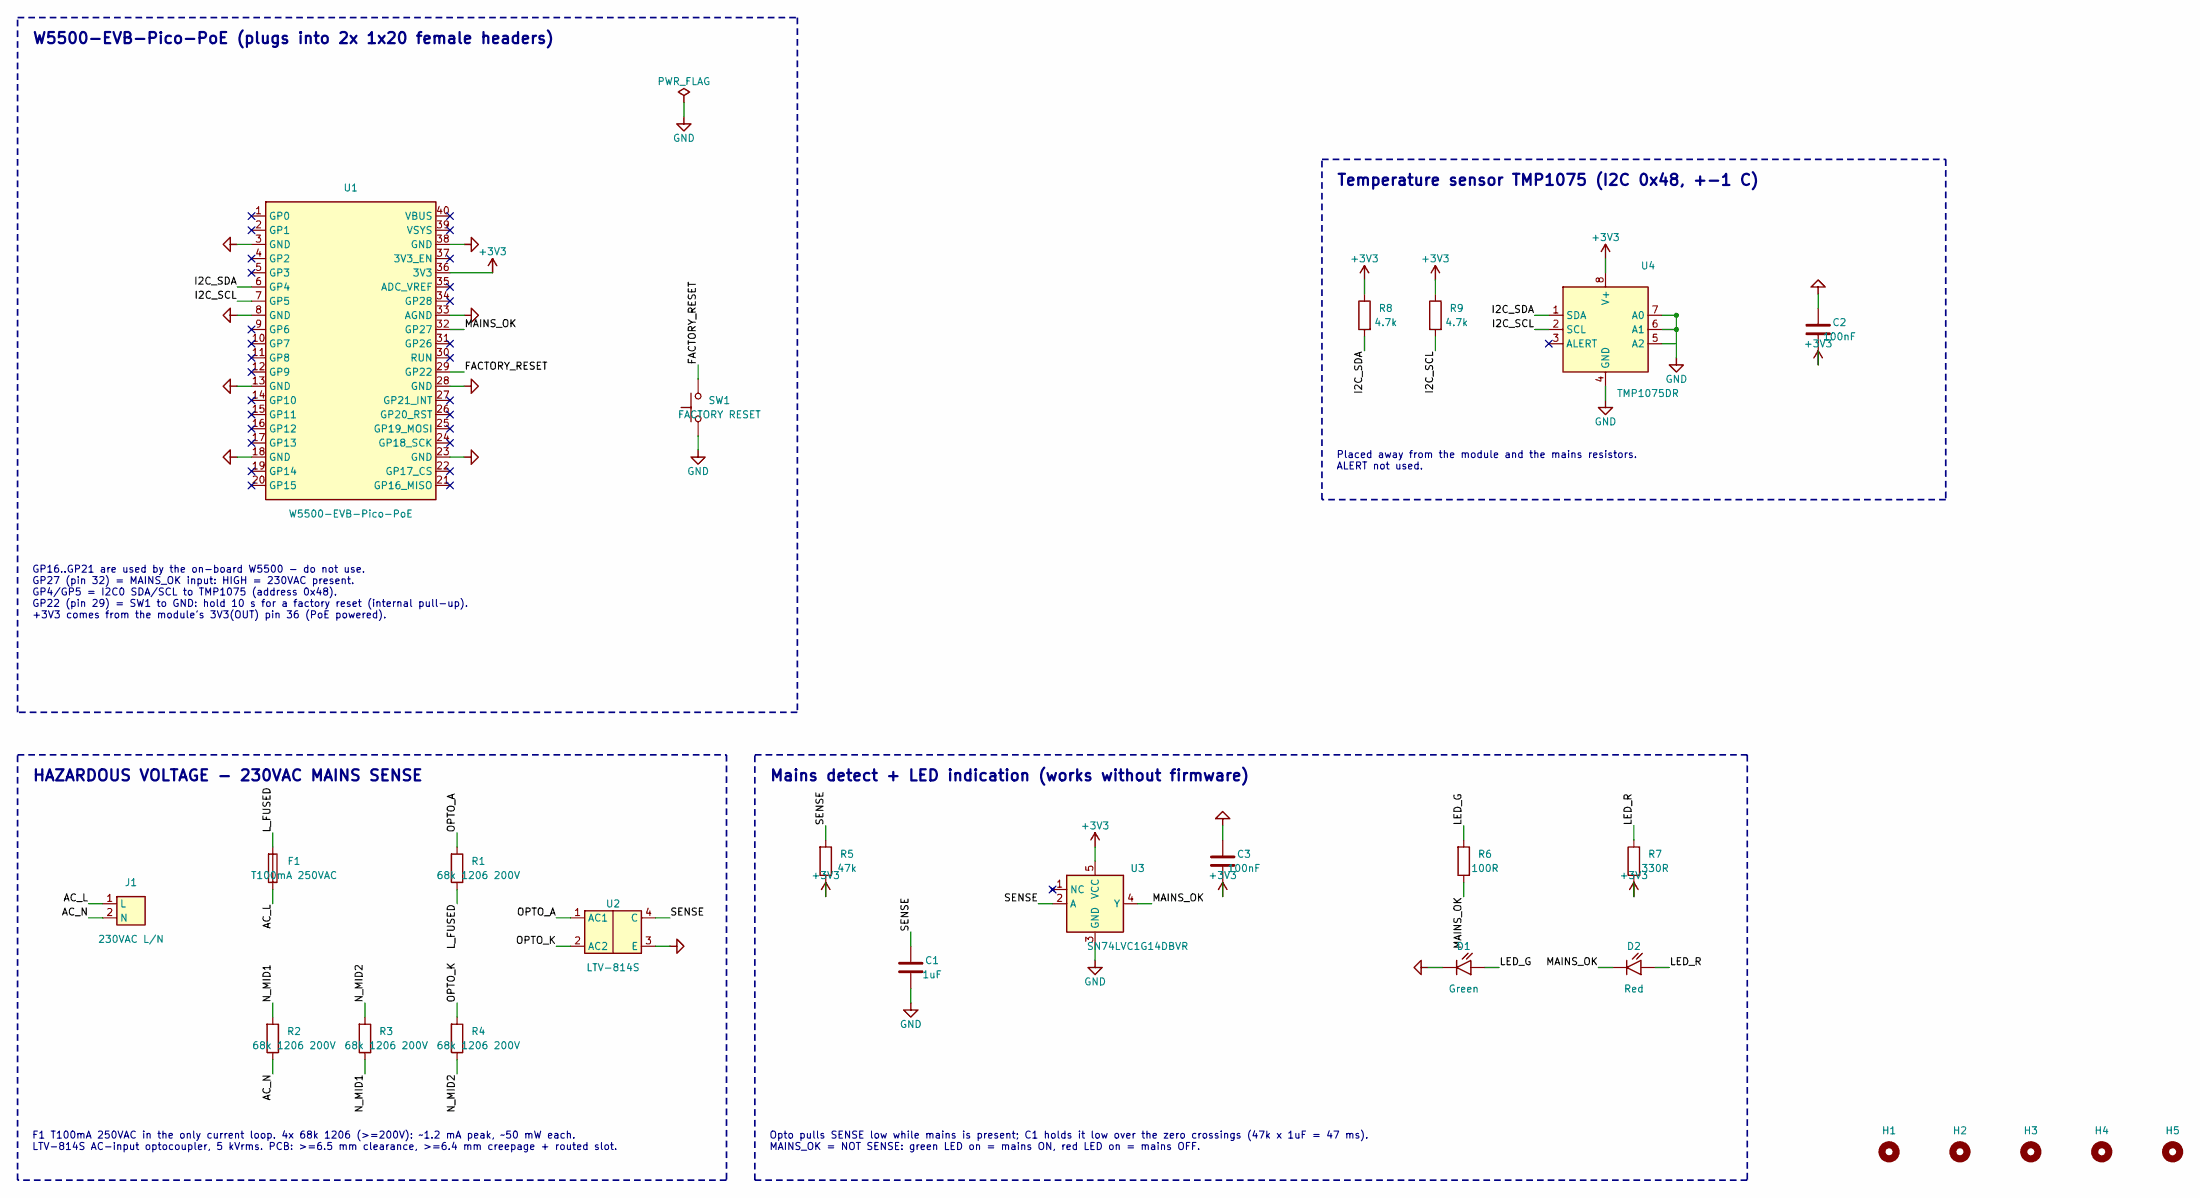
[picture p16: schematic pico-poe-mains-carrier.kicad_sch, RF-UPS-Monitor carrier for the W5500-EVB-Pico-PoE]

Parts:
C1: 1uF; C_0603_1608Metric; LCSC C15849
C2, C3: 100nF; C_0603_1608Metric; LCSC C14663
D1: Green; LED_0805_2012Metric; LCSC C2297
D2: Red; LED_0805_2012Metric; LCSC C84256
F1: T100mA 250VAC; Fuse_Schurter_UMT250; MPN Schurter 3403.0156.11 (UMT 250, T 100 m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
H1, H2, H3: MountingHole_3.2mm_M3
H4, H5: MountingHole_3.2mm_M3; MountingHole_3.2mm_M3_UnderModule
J1: 230VAC L/N; TerminalBlock_Phoenix_MKDS-1,5-2-5.08_1x02_P5.08mm_Horizont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; MPN Phoenix 1715721 (MKDS 1,5/2-5,08)
R1, R2, R3, R4: 68k 1206 200V; R_1206_3216Metric; LCSC C2889820
R5: 47k; R_0603_1608Metric; LCSC C25819
R6: 100R; R_0603_1608Metric; LCSC C22775
R7: 330R; R_0603_1608Metric; LCSC C23138
R8, R9: 4.7k; R_0603_1608Metric; LCSC C23162
SW1: FACTORY RESET; SW_Push_1P1T_XKB_TS-1187A; MPN XKB TS-1187A-B-A-B; LCSC C318884
U1: W5500-EVB-Pico-PoE; W5500-EVB-Pico-PoE_Socket; MPN W5500-EVB-Pico-PoE
U2: LTV-814S; SMDIP-4_W9.53mm; MPN LTV-814S-TA1; LCSC C125118
U3: SN74LVC1G14DBVR; SOT-23-5; LCSC C7835
U4: TMP1075DR; SOIC-8_3.9x4.9mm_P1.27mm; LCSC C2878381

Connections:
+3V3: C2.1, C3.2, R5.2, R7.1, R8.2, R9.2, U1.36 (3V3), U3.5 (VCC), U4.8 (V+)
/AC_L: F1.2, J1.1 (L)
/AC_N: J1.2 (N), R2.2
/FACTORY_RESET: SW1.1, U1.29 (GP22)
/I2C_SCL: R9.1, U1.7 (GP5), U4.2 (SCL)
/I2C_SDA: R8.1, U1.6 (GP4), U4.1 (SDA)
/LED_G: D1.2 (A), R6.1
/LED_R: D2.2 (A), R7.2
/L_FUSED: F1.1, R1.2
/MAINS_OK: D2.1 (K), R6.2, U1.32 (GP27), U3.4 (Y)
/N_MID1: R2.1, R3.2
/N_MID2: R3.1, R4.2
/OPTO_A: R1.1, U2.1 (AC1)
/OPTO_K: R4.1, U2.2 (AC2)
/SENSE: C1.1, R5.1, U2.4 (C), U3.2 (A)
GND: C1.2, C2.2, C3.1, D1.1 (K), SW1.2, U1.3 (GND), U1.8 (GND), U1.13 (GND), U1.18 (GND), U1.23 (GND), U1.28 (GND), U1.33 (AGND), U1.38 (GND), U2.3 (E), U3.3 (GND), U4.4 (GND), U4.5 (A2), U4.6 (A1), U4.7 (A0)

Notes on the sheet:
W5500-EVB-Pico-PoE (plugs into 2x 1x20 female headers)
GP16..GP21 are used by the on-board W5500 - do not use. GP27 (pin 32) = MAINS_OK input: HIGH = 230VAC present. GP4/GP5 = I2C0 SDA/SCL to TMP1075 (address 0x48). GP22 (pin 29) = SW1 to GND: hold 10 s for a factory reset (internal pull-up). +3V3 comes from the module's 3V3(OUT) pin 36 (PoE powered).
HAZARDOUS VOLTAGE - 230VAC MAINS SENSE
F1 T100mA 250VAC in the only current loop. 4x 68k 1206 (>=200V): ~1.2 mA peak, ~50 mW each. LTV-814S AC-input optocoupler, 5 kVrms. PCB: >=6.5 mm clearance, >=6.4 mm creepage + routed slot.
Mains detect + LED indication (works without firmware)
Opto pulls SENSE low while mains is present; C1 holds it low over the zero crossings (47k x 1uF = 47 ms). MAINS_OK = NOT SENSE: green LED on = mains ON, red LED on = mains OFF.
Temperature sensor TMP1075 (I2C 0x48, +-1 C)
Placed away from the module and the mains resistors. ALERT not used.

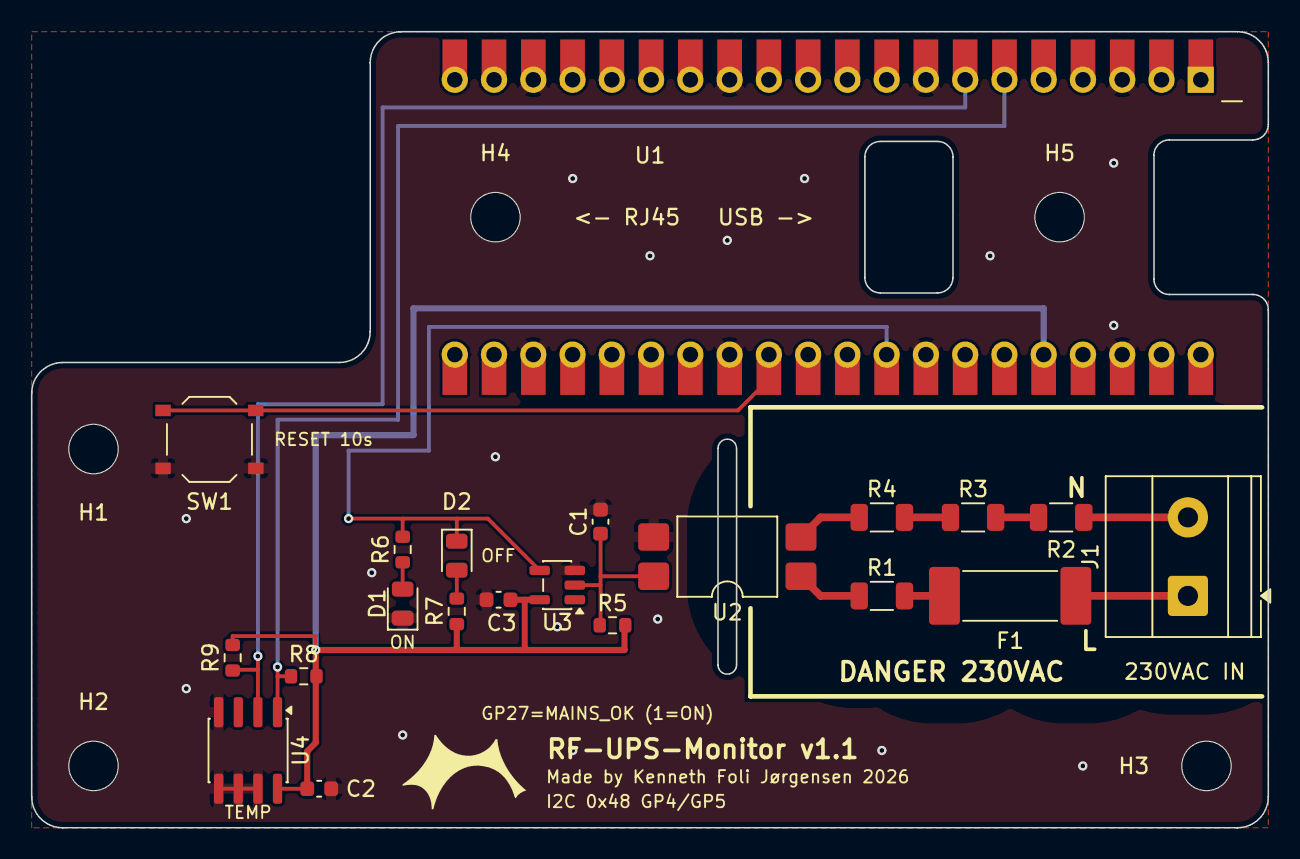
[picture p17: board pico-poe-mains-carrier.kicad_pcb from above]

Board: 2 copper layers, 80.0 x 51.5 mm, 26 parts (0 on the bottom side), 16 nets.
