TheKingOfChaos/RF-UPS-Monitor/src/snmp_service.cpp

#include "snmp_service.h"

#include <Arduino.h>
#include <WiFiUdp.h>
#include <mains_input.h>
#include <netconfig.h>
#include <settings.h>
#include <snmp_trap.h>
#include "board_temp.h"
#include "net_stats.h"
#include "source_key.h"
#include "version.h"

// Requests handled per snmpPoll() call, so a flood cannot starve the menu
const uint8_t MAX_PACKETS_PER_POLL = 4;

static const char* const SYS_DESCR = "RF-UPS-Monitor " FIRMWARE_VERSION " mains power monitor (RP2040, W5500)";

static WiFiUDP udp;
static bool started = false;
static bool coldStartSent = false;
static uint8_t agentAddr[4] = {0, 0, 0, 0};

static SnmpAgent agent(currentSettings.community);
static RateLimiter limiter(SNMP_RATE_PER_SECOND, SNMP_RATE_BURST, SNMP_GLOBAL_RATE_PER_SECOND,
                           SNMP_GLOBAL_RATE_BURST);
static AccessLog accessLog;
static TrapThrottle authTrapThrottle(AUTH_TRAP_INTERVAL_MS);
static SnmpServiceStats serviceStats = {};

static uint8_t inBuf[SNMP_MAX_MESSAGE];
static uint8_t outBuf[SNMP_MAX_MESSAGE];
/// Largest reply over IPv6: 1500 - 40 (IPv6) - 8 (UDP); IPv4 allows SNMP_MAX_MESSAGE (1472)
static const size_t SNMP_MAX_MESSAGE_IPV6 = 1452;

/**
 * @brief sysUpTime in hundredths of a second, from the 64-bit microsecond timer
 *
 * Wraps after 497 days like any TimeTicks counter, not after millis()' 49 days.
 */
static uint32_t uptimeTicks() {
    return (uint32_t)(time_us_64() / 10000);
}

/**
 * @brief Collect the values the MIB reports
 */
static SnmpDeviceState captureState() {
    SnmpDeviceState s = {};
    s.uptimeTicks = uptimeTicks();
    // Read from the settings on every request, so menu changes apply immediately
    s.sysDescr = SYS_DESCR;
    s.sysContact = currentSettings.sysContact;
    s.sysName = currentSettings.sysName;
    s.sysLocation = currentSettings.sysLocation;
    netStatsCapture(s.iface);
    s.boardTempDeciC = boardTempDeciC();

    MainsSnapshot mains;
    if (mainsRead(mains)) {
        s.mainsPresent = mains.present;
        s.mainsChanges = mains.changes;
        if (mains.changes > 0) {
            // sysUpTime at the change, from the elapsed time (wrap-safe for 49 days)
            uint32_t agoTicks = (millis() - mains.lastChangeMs) / 10;
            s.mainsLastChangeTicks = s.uptimeTicks - agoTicks;
        }
    }
    return s;
}

/**
 * @brief Record a rejected request and print it when it starts a new log entry
 */
static void logAccess(const SourceKey& source, AccessEvent event) {
    if (accessLog.record(source, event, millis())) {
        char ip[SOURCE_TEXT_MAX];
        formatSource(source, ip);
        bool web = event == AccessEvent::WebLoginFailed || event == AccessEvent::WebLoginLocked;
        Serial.printf("\n%s access: %s from %s\n", web ? "Web" : "SNMP", accessEventName(event), ip);
    }
}

void accessLogRecord(const SourceKey& source, AccessEvent event) {
    logAccess(source, event);
}

/// request-id of the next v2c trap
static int32_t nextTrapRequestId = 1;

enum class TrapKind { ColdStart, AuthFailure, Mains };

/**
 * @brief Encode a trap in the configured version (v1 Trap-PDU or v2c SNMPv2-Trap)
 */
static size_t buildTrap(TrapKind kind, const SnmpDeviceState& state) {
    const char* c = currentSettings.community;
    if (currentSettings.trapVersion == TRAP_VERSION_V1) {
        switch (kind) {
        case TrapKind::ColdStart:   return snmpBuildColdStartTrap(c, agentAddr, state.uptimeTicks, outBuf, sizeof(outBuf));
        case TrapKind::AuthFailure: return snmpBuildAuthFailureTrap(c, agentAddr, state.uptimeTicks, outBuf, sizeof(outBuf));
        case TrapKind::Mains:       return snmpBuildMainsTrap(c, agentAddr, state, outBuf, sizeof(outBuf));
        }
        return 0;
    }
    int32_t id = nextTrapRequestId++;
    switch (kind) {
    case TrapKind::ColdStart:   return snmpBuildColdStartTrapV2c(c, state.uptimeTicks, id, outBuf, sizeof(outBuf));
    case TrapKind::AuthFailure: return snmpBuildAuthFailureTrapV2c(c, state.uptimeTicks, id, outBuf, sizeof(outBuf));
    case TrapKind::Mains:       return snmpBuildMainsTrapV2c(c, state, id, outBuf, sizeof(outBuf));
    }
    return 0;
}

bool snmpTrapTarget(uint8_t out[4]) {
    if (!currentSettings.trapFromDhcp) {
        return currentSettings.trapTarget[0] != '\0' && parseIPv4(currentSettings.trapTarget, out);
    }
    // Only the ACK for the lease in use counts; a static IP never has one
    DhcpTrapInfo d = netStatsDhcpTrap();
    if (!currentSettings.dhcpEnabled || !d.seen || !d.hasOption || memcmp(d.yiaddr, agentAddr, 4) != 0) return false;
    memcpy(out, d.target, 4);
    return true;
}

/**
 * @brief Send an encoded trap to the destination in use, if any
 */
static void sendTrap(size_t len, const char* what) {
    uint8_t target[4];
    if (!snmpTrapTarget(target)) return;
    char targetText[16];
    snprintf(targetText, sizeof(targetText), "%u.%u.%u.%u", target[0], target[1], target[2], target[3]);
    if (len == 0) {
        serviceStats.trapsFailed++;
        return;
    }
    IPAddress dest(target[0], target[1], target[2], target[3]);
    bool ok = udp.beginPacket(dest, SNMP_TRAP_PORT) == 1 && udp.write(outBuf, len) == len && udp.endPacket() == 1;
    if (ok) {
        serviceStats.trapsSent++;
        Serial.printf("SNMP %s trap %s sent to %s\n", currentSettings.trapVersion == TRAP_VERSION_V1 ? "v1" : "v2c",
                      what, targetText);
    } else {
        serviceStats.trapsFailed++;
        Serial.printf("SNMP trap %s to %s failed\n", what, targetText);
    }
}

bool snmpBegin() {
    limiter.configureTrusted(SNMP_TRUSTED_RATE_PER_SECOND, SNMP_TRUSTED_RATE_BURST, SNMP_MAX_TRUSTED_SOURCES,
                             SNMP_TRUST_TIMEOUT_MS);
    started = udp.begin(SNMP_PORT) == 1;
    Serial.printf(started ? "SNMP agent listening on UDP %u\n" : "SNMP: cannot bind UDP %u\n", SNMP_PORT);
    return started;
}

void snmpNetworkUp(const IPAddress& localIP) {
    for (int i = 0; i < 4; i++) agentAddr[i] = localIP[i];
    if (!started || coldStartSent) return;
    coldStartSent = true;
    sendTrap(buildTrap(TrapKind::ColdStart, captureState()), "coldStart");
}

void snmpCommunityChanged() {
    // Trust was earned with the old community and must not carry over
    limiter.clearTrust();
    Serial.println("SNMP: community changed, rate-limit trust cleared");
}

void snmpNotifyMainsChange() {
    if (!started) return;
    SnmpDeviceState state = captureState();
    sendTrap(buildTrap(TrapKind::Mains, state), state.mainsPresent ? "mainsPowerRestored" : "mainsPowerLost");
}

void snmpPoll() {
    if (!started) return;

    for (uint8_t i = 0; i < MAX_PACKETS_PER_POLL; i++) {
        int size = udp.parsePacket();
        if (size <= 0) return;

        SourceKey source;
        if (!sourceKeyOf(udp.remoteIP(), source)) {
            udp.flush();  // IPv6 source in ::/32: cannot be a real LAN host
            continue;
        }
        if ((size_t)size > sizeof(inBuf)) {
            udp.flush();  // Larger than any valid SNMP v1 request we accept
            logAccess(source, AccessEvent::Malformed);
            continue;
        }
        if (!limiter.allow(source, millis())) {
            udp.flush();
            serviceStats.rateLimited++;
            logAccess(source, AccessEvent::RateLimited);
            continue;
        }

        int n = udp.read(inBuf, sizeof(inBuf));
        if (n <= 0) continue;

        IPAddress remote = udp.remoteIP();
        uint16_t remotePort = udp.remotePort();
        // One Ethernet frame without fragmentation: IPv6 headers are 20 bytes longer than IPv4's
        // (and IPv6 fragmentation is off, see platformio.ini)
        size_t outMax = remote.isV6() ? SNMP_MAX_MESSAGE_IPV6 : sizeof(outBuf);
        size_t len = agent.handle(inBuf, (size_t)n, outBuf, outMax, captureState());

        switch (agent.lastOutcome()) {
        case SnmpOutcome::Responded:
        case SnmpOutcome::NoRoom:
            // Right community: exempt from the shared bucket, so spoofed floods cannot starve it
            limiter.markTrusted(source);
            break;
        case SnmpOutcome::RespondedBulk:
            // A GetBulk with a spoofed source must not give that address the larger trusted budget
            break;
        case SnmpOutcome::BadCommunity:
            logAccess(source, AccessEvent::BadCommunity);
            if (authTrapThrottle.allow(millis())) {
                sendTrap(buildTrap(TrapKind::AuthFailure, captureState()), "authenticationFailure");
            }
            break;
        case SnmpOutcome::BadVersion:  logAccess(source, AccessEvent::BadVersion); break;
        case SnmpOutcome::ParseError:  logAccess(source, AccessEvent::Malformed); break;
        case SnmpOutcome::SetRejected:
            limiter.markTrusted(source);
            logAccess(source, AccessEvent::SetRejected);
            break;
        default: break;
        }
        if (len == 0) continue;

        udp.beginPacket(remote, remotePort);
        udp.write(outBuf, len);
        udp.endPacket();
    }
}

uint32_t snmpUptimeTicks() {
    return uptimeTicks();
}

const SnmpStats& snmpStats() {
    return agent.stats();
}

const SnmpServiceStats& snmpServiceStats() {
    return serviceStats;
}

const AccessLog& snmpAccessLog() {
    return accessLog;
}
