TheKingOfChaos/RF-UPS-Monitor/test/hil/test_snmp.py

"""Hardware-in-the-loop tests for the SNMP v1 agent on the flashed device.

Uses the real net-snmp tools (snmpget, snmpgetnext, snmpwalk, snmpset) in
WSL, and raw UDP from Windows for timing and malformed-packet floods. The
device IP is read from the serial status screen, so the serial port must be
free (close PuTTY).

Run (from the project root, firmware flashed):
    %USERPROFILE%\\.platformio\\penv\\Scripts\\python.exe -m unittest discover -s test/hil -p "test_snmp.py" -v

Environment variables:
    RFUPS_PORT          Serial port, default COM16
    RFUPS_WSL_DISTRO    WSL distribution with net-snmp, default Ubuntu-24.04
    RFUPS_MAINS_SWITCH / RFUPS_MANUAL_MAINS  Mains tests, see mains_switch.py

The device must use community "public"; tests that change the SNMP
settings restore them afterwards.
"""

import os
import re
import socket
import statistics
import struct
import time
import unittest

from device import Device
from mains_switch import get_switch, skip_without_switch, wait_until
from snmp_tools import (GET_SYSDESCR, REQUEST_ID_OFFSET, garbage_packets, local_ip_towards, net_snmp,
                        raw_get, response_request_id, send_raw)

ENTERPRISE = "1.3.6.1.4.1.63050"


def all_oids(v1):
    """Every object of the MIB in walk order; v1 does not see the eight Counter64 ifHC* columns."""
    oids = [".1.3.6.1.2.1.1.%d.0" % i for i in range(1, 8)]
    oids += [".1.3.6.1.2.1.2.1.0"]
    oids += [".1.3.6.1.2.1.2.2.1.%d.1" % i for i in range(1, 23)]
    oids += [".1.3.6.1.2.1.31.1.1.1.%d.1" % i for i in range(1, 20) if not (v1 and 6 <= i <= 13)]
    oids += ["." + ENTERPRISE + ".%d.0" % i for i in range(1, 5)]
    return oids


def v3_packet():
    """The captured v1 GetRequest with its version field set to 3 (SNMPv3)."""
    pkt = bytearray(GET_SYSDESCR)
    pkt[4] = 3
    return bytes(pkt)
NO_SUCH = r"\(noSuchName\) There is no such variable name in this MIB\.\s+Failed object: "


class SnmpAgentTest(unittest.TestCase):

    @classmethod
    def setUpClass(cls):
        cls.dev = Device()
        cls.dev.open()
        cls.dev.wait_for_menu()
        cls.ip = cls.dev.wait_connected()["ip"]
        community = cls.dev.status()["community"]
        if community != "public":
            cls.dev.close()
            raise unittest.SkipTest('device community is "%s"; set it to "public" (menu option 4) '
                                    "before running the SNMP HIL tests" % community)

    @classmethod
    def tearDownClass(cls):
        cls.dev.close()

    def snmp(self, tool, *args, **kw):
        return net_snmp(tool, self.ip, *args, **kw)

    def snmp_stats(self):
        """SNMP counters from the serial status screen."""
        self.dev.wait_for_menu(timeout=10)
        raw = self.dev.status()["raw"]
        m = re.search(r"SNMP: (\d+) packets, (\d+) responses \(get (\d+), getnext (\d+), set (\d+)\), "
                      r"bad community (\d+), bad version (\d+), malformed (\d+)", raw)
        self.assertIsNotNone(m, raw)
        keys = ("packets", "responses", "get", "getnext", "set", "bad_community", "bad_version", "malformed")
        return dict(zip(keys, map(int, m.groups())))

    # ---- GetRequest ----

    def test_get_sysdescr(self):
        rc, out = self.snmp("snmpget", "1.3.6.1.2.1.1.1.0")
        self.assertEqual(0, rc, out)
        self.assertRegex(out, r'\.1\.3\.6\.1\.2\.1\.1\.1\.0 = STRING: "RF-UPS-Monitor \d+\.\d+\.\d+ ')

    def test_get_sysobjectid_is_enterprise(self):
        rc, out = self.snmp("snmpget", "1.3.6.1.2.1.1.2.0")
        self.assertIn("OID: ." + ENTERPRISE, out)

    def test_sysuptime_advances(self):
        def ticks():
            rc, out = self.snmp("snmpget", "1.3.6.1.2.1.1.3.0")
            m = re.search(r"Timeticks: \((\d+)\)", out)
            self.assertIsNotNone(m, out)
            return int(m.group(1))
        t1 = ticks()
        time.sleep(1.0)
        t2 = ticks()
        self.assertGreaterEqual(t2 - t1, 90, "sysUpTime advanced %d ticks in ~1 s" % (t2 - t1))
        self.assertLess(t2 - t1, 300)

    def test_mains_status_matches_serial_status(self):
        rc, out = self.snmp("snmpget", ENTERPRISE + ".1.0", ENTERPRISE + ".2.0", ENTERPRISE + ".3.0")
        self.assertEqual(0, rc, out)
        m = re.search(r"63050\.1\.0 = INTEGER: (\d)", out)
        self.assertIsNotNone(m, out)
        self.assertRegex(out, r"63050\.2\.0 = Counter32: \d+")
        self.assertRegex(out, r"63050\.3\.0 = Timeticks: \(\d+\)")
        serial = self.dev.status()["mains"]
        self.assertEqual("present" if m.group(1) == "1" else "LOST", serial)

    def test_get_several_varbinds_in_request_order(self):
        rc, out = self.snmp("snmpget", ENTERPRISE + ".1.0", "1.3.6.1.2.1.1.5.0", "1.3.6.1.2.1.1.7.0")
        self.assertEqual(0, rc, out)
        lines = [l for l in out.splitlines() if " = " in l]
        self.assertEqual(3, len(lines), out)
        self.assertTrue(lines[0].startswith("." + ENTERPRISE + ".1.0"))
        self.assertIn('STRING: "%s"' % self.dev.status()["sysName"], lines[1])
        self.assertIn("INTEGER: 72", lines[2])

    def test_get_unknown_oid_is_no_such_name(self):
        rc, out = self.snmp("snmpget", "1.3.6.1.2.1.1.1.0", "1.3.6.1.2.1.1.99.0")
        self.assertNotEqual(0, rc)
        self.assertRegex(out, NO_SUCH + r"\.1\.3\.6\.1\.2\.1\.1\.99\.0")

    # ---- GetNextRequest / walk ----

    def test_walk_returns_all_objects_in_order(self):
        rc, out = self.snmp("snmpwalk", ".1")
        self.assertEqual(0, rc, out)
        oids = [l.split(" = ")[0] for l in out.splitlines() if " = " in l]
        self.assertEqual(all_oids(v1=True), oids)
        self.assertIn("End of MIB", out)

    def test_walk_enterprise_subtree(self):
        rc, out = self.snmp("snmpwalk", ENTERPRISE)
        self.assertEqual(4, sum(1 for l in out.splitlines() if " = " in l), out)

    def test_walk_system_group(self):
        rc, out = self.snmp("snmpwalk", "1.3.6.1.2.1.1")
        self.assertEqual(7, sum(1 for l in out.splitlines() if " = " in l), out)

    def test_getnext_past_end(self):
        rc, out = self.snmp("snmpgetnext", ENTERPRISE + ".4.0")
        self.assertRegex(out, NO_SUCH + r"\." + ENTERPRISE.replace(".", r"\.") + r"\.4\.0")

    # ---- rejected requests ----

    def test_set_is_rejected_and_changes_nothing(self):
        rc, out = self.snmp("snmpset", "1.3.6.1.2.1.1.5.0", "s", "hacked")
        self.assertNotEqual(0, rc)
        self.assertRegex(out, NO_SUCH + r"\.1\.3\.6\.1\.2\.1\.1\.5\.0")
        rc, out = self.snmp("snmpget", "1.3.6.1.2.1.1.5.0")
        self.assertIn('STRING: "%s"' % self.dev.status()["sysName"], out)

    def test_wrong_community_gets_no_reply_and_is_counted(self):
        before = self.snmp_stats()["bad_community"]
        rc, out = self.snmp("snmpget", "1.3.6.1.2.1.1.1.0", community="not-public", timeout=1)
        self.assertIn("Timeout", out)
        self.assertEqual(before + 1, self.snmp_stats()["bad_community"])

    def test_v3_gets_no_reply_and_is_counted(self):
        before = self.snmp_stats()["bad_version"]
        resp, _ = raw_get(self.ip, 0, timeout=1.0, packet=v3_packet())
        self.assertIsNone(resp, "SNMPv3 must not be answered")
        self.assertEqual(before + 1, self.snmp_stats()["bad_version"])

    # ---- v2c ----

    def test_v2c_get(self):
        rc, out = self.snmp("snmpget", "1.3.6.1.2.1.1.1.0", ENTERPRISE + ".1.0", version="2c")
        self.assertEqual(0, rc, out)
        self.assertRegex(out, r'1\.1\.0 = STRING: "RF-UPS-Monitor \d+\.\d+\.\d+ ')
        self.assertRegex(out, r"63050\.1\.0 = INTEGER: [01]")

    def test_v2c_exceptions_instead_of_errors(self):
        rc, out = self.snmp("snmpget", "1.3.6.1.2.1.1.5.0", "1.3.6.1.2.1.1.99.0", "1.3.6.1.2.1.1.1.5",
                            version="2c")
        self.assertRegex(out, r'1\.5\.0 = STRING: ".*"')
        self.assertIn("1.99.0 = No Such Object available on this agent at this OID", out)
        self.assertIn("1.1.5 = No Such Instance currently exists at this OID", out)

    def test_v2c_walk_ends_with_end_of_mib_view(self):
        rc, out = self.snmp("snmpwalk", ".1", version="2c")
        self.assertEqual(0, rc, out)
        oids = [l.split(" = ")[0] for l in out.splitlines() if " = " in l and "No more variables" not in l]
        self.assertEqual(all_oids(v1=False), oids)
        self.assertIn("No more variables left in this MIB View", out)

    def test_bulkwalk_returns_the_same_objects_as_walk(self):
        before = self.dev.status()["getBulkRequests"]
        rc, bulk = self.snmp("snmpbulkwalk", ".1", version="2c")
        self.assertEqual(0, rc, bulk)
        rc, walk = self.snmp("snmpwalk", ".1", version="2c")

        def oids(text):
            # Compare names and types only: uptime and traffic counters change between the walks
            return [(l.split(" = ")[0], l.split(" = ")[1].split(":")[0]) for l in text.splitlines()
                    if " = " in l and "No more" not in l]
        self.assertEqual(oids(walk), oids(bulk))
        self.assertEqual(len(all_oids(v1=False)), len(oids(bulk)))
        # 53 objects at most 16 per GetBulk: at least 4 requests
        self.assertGreaterEqual(self.dev.status()["getBulkRequests"] - before, 4)

    def test_bulkget_non_repeaters_and_repetitions(self):
        rc, out = self.snmp("snmpbulkget", "-Cn1", "-Cr3", "1.3.6.1.2.1.1.3.0", "1.3.6.1.2.1.1", version="2c")
        self.assertEqual(0, rc, out)
        oids = [l.split(" = ")[0] for l in out.splitlines() if " = " in l]
        self.assertEqual([".1.3.6.1.2.1.1.4.0", ".1.3.6.1.2.1.1.1.0", ".1.3.6.1.2.1.1.2.0",
                          ".1.3.6.1.2.1.1.3.0"], oids)

    def test_bulkget_is_capped_at_16_varbinds(self):
        # Limits reflection: a short request never gets a huge reply
        rc, out = self.snmp("snmpbulkget", "-Cn0", "-Cr1000", ".1", version="2c")
        self.assertEqual(0, rc, out)
        self.assertEqual(16, sum(1 for l in out.splitlines() if " = " in l))

    def test_bulkget_reaches_end_of_mib_view(self):
        rc, out = self.snmp("snmpbulkget", "-Cn0", "-Cr1000", ENTERPRISE, version="2c")
        self.assertEqual(0, rc, out)
        self.assertIn("No more variables left in this MIB View", out)
        self.assertEqual(4, sum(1 for l in out.splitlines() if " = " in l and "No more" not in l))

    # ---- IF-MIB ----

    IF_OIDS = {"ifDescr": "2.2.1.2", "ifType": "2.2.1.3", "ifMtu": "2.2.1.4", "ifSpeed": "2.2.1.5",
               "ifPhysAddress": "2.2.1.6", "ifAdminStatus": "2.2.1.7", "ifOperStatus": "2.2.1.8",
               "ifInOctets": "2.2.1.10", "ifInDiscards": "2.2.1.13", "ifInErrors": "2.2.1.14",
               "ifInUnknownProtos": "2.2.1.15", "ifOutDiscards": "2.2.1.19", "ifOutErrors": "2.2.1.20",
               "ifName": "31.1.1.1.1", "ifHCInOctets": "31.1.1.1.6",
               "ifHCInUcastPkts": "31.1.1.1.7", "ifHCOutOctets": "31.1.1.1.10",
               "ifHCOutUcastPkts": "31.1.1.1.11", "ifHighSpeed": "31.1.1.1.15"}

    def ifmib(self, *names, version="2c"):
        """One snmpget for IF-MIB columns of interface 1; returns ({name: value text}, output)."""
        oids = {".1.3.6.1.2.1.%s.1" % self.IF_OIDS[n]: n for n in names}
        rc, out = self.snmp("snmpget", *oids, version=version)
        values = {}
        for line in out.splitlines():
            oid, sep, value = line.partition(" = ")
            if sep and oid in oids:
                values[oids[oid]] = value.strip()
        return values, out

    def test_if_table_describes_the_ethernet_port(self):
        v, out = self.ifmib("ifDescr", "ifType", "ifMtu", "ifAdminStatus", "ifOperStatus", "ifName")
        self.assertEqual('STRING: "W5500 10/100 Ethernet"', v.get("ifDescr"), out)
        self.assertEqual("INTEGER: 6", v.get("ifType"))
        self.assertEqual("INTEGER: 1500", v.get("ifMtu"))
        self.assertEqual("INTEGER: 1", v.get("ifAdminStatus"))
        self.assertEqual("INTEGER: 1", v.get("ifOperStatus"))
        self.assertEqual('STRING: "eth0"', v.get("ifName"))

    def test_if_speed_and_mac_match_the_device(self):
        st = self.dev.status()
        v, out = self.ifmib("ifSpeed", "ifHighSpeed", "ifPhysAddress")
        self.assertTrue(st["linkUp"])
        self.assertIn(st["linkMbps"], (10, 100))
        self.assertEqual("Gauge32: %d" % (st["linkMbps"] * 1000000), v.get("ifSpeed"), out)
        self.assertEqual("Gauge32: %d" % st["linkMbps"], v.get("ifHighSpeed"))
        # Without a MIB net-snmp prints the six raw bytes as Hex-STRING: 1E B2 ...
        self.assertEqual("Hex-STRING: " + st["mac"].replace(":", " "), v.get("ifPhysAddress"))

    def test_traffic_counters_count_real_packets(self):
        names = ("ifHCInUcastPkts", "ifHCOutUcastPkts", "ifHCInOctets", "ifHCOutOctets")

        def read():
            v, out = self.ifmib(*names)
            return {n: int(re.search(r"Counter64: (\d+)", v[n]).group(1)) for n in names}
        before = read()
        for i in range(20):
            self.assertIsNotNone(raw_get(self.ip, 9000 + i)[0])
        after = read()
        # 20 requests and 20 replies, plus the second snmpget itself
        self.assertGreaterEqual(after["ifHCInUcastPkts"] - before["ifHCInUcastPkts"], 21)
        self.assertGreaterEqual(after["ifHCOutUcastPkts"] - before["ifHCOutUcastPkts"], 20)
        self.assertGreaterEqual(after["ifHCInOctets"] - before["ifHCInOctets"], 20 * len(GET_SYSDESCR))
        self.assertGreater(after["ifHCOutOctets"], before["ifHCOutOctets"])

    def test_32_bit_counters_follow_64_bit_ones(self):
        v, out = self.ifmib("ifInOctets", "ifHCInOctets")
        c32 = int(re.search(r"Counter32: (\d+)", v["ifInOctets"]).group(1))
        c64 = int(re.search(r"Counter64: (\d+)", v["ifHCInOctets"]).group(1))
        # Read in one request: the 32-bit value is the low half of the 64-bit one
        self.assertEqual(c64 & 0xFFFFFFFF, c32, out)

    def test_receive_drop_counters_match_the_status_screen(self):
        # The values depend on the LAN (e.g. LLDP or IPv6 frames are unknown protocols), so compare
        # SNMP with the status screen read just before: never lower, and only a little higher
        st = self.dev.status()
        for key in ("inDiscards", "inErrors", "inUnknownProtos", "outErrors"):
            self.assertIsNotNone(st[key], "status screen has no 'Ethernet drops' line:\n" + st["raw"])
        v, out = self.ifmib("ifInDiscards", "ifInErrors", "ifInUnknownProtos", "ifOutDiscards", "ifOutErrors")
        for name, key in (("ifInDiscards", "inDiscards"), ("ifInErrors", "inErrors"),
                          ("ifInUnknownProtos", "inUnknownProtos"), ("ifOutErrors", "outErrors")):
            m = re.match(r"Counter32: (\d+)$", v.get(name, ""))
            self.assertIsNotNone(m, out)
            self.assertGreaterEqual(int(m.group(1)), st[key], name)
            self.assertLessEqual(int(m.group(1)), st[key] + 20, name)
        self.assertEqual("Counter32: 0", v.get("ifOutDiscards"))

    def test_counter64_not_available_in_v1(self):
        rc, out = self.snmp("snmpget", "1.3.6.1.2.1.31.1.1.1.6.1")
        self.assertRegex(out, NO_SUCH + r"\.1\.3\.6\.1\.2\.1\.31\.1\.1\.1\.6\.1")

    # ---- board temperature ----

    def test_board_temperature_is_plausible_and_matches_status(self):
        rc, out = self.snmp("snmpget", ENTERPRISE + ".4.0", version="2c")
        deci = int(re.search(r"63050\.4\.0 = INTEGER: (-?\d+)", out).group(1))
        self.assertGreater(deci, 100, "below 10 C")
        self.assertLess(deci, 850, "above 85 C")
        status_c = self.dev.status()["boardTempC"]
        self.assertAlmostEqual(deci / 10.0, status_c, delta=2.0)

    def test_v2c_set_is_not_writable(self):
        rc, out = self.snmp("snmpset", "1.3.6.1.2.1.1.5.0", "s", "hacked", version="2c")
        self.assertNotEqual(0, rc)
        self.assertRegex(out, r"notWritable[\s\S]*Failed object: \.1\.3\.6\.1\.2\.1\.1\.5\.0")
        rc, out = self.snmp("snmpget", "1.3.6.1.2.1.1.5.0", version="2c")
        self.assertNotIn("hacked", out)

    def test_v2c_wrong_community_gets_no_reply(self):
        rc, out = self.snmp("snmpget", "1.3.6.1.2.1.1.1.0", community="nope", version="2c", timeout=1)
        self.assertIn("Timeout", out)

    def test_v1_and_v2c_counters(self):
        before = self.dev.status()["v2cRequests"]
        self.snmp("snmpget", "1.3.6.1.2.1.1.1.0", version="2c")
        self.snmp("snmpget", "1.3.6.1.2.1.1.1.0", version="1")
        self.assertEqual(before + 1, self.dev.status()["v2cRequests"])

    # ---- SNMP settings from the serial menu ----

    def test_snmp_settings_from_menu_apply_immediately(self):
        d = self.dev
        before = d.status()
        packets_before = self.snmp_stats()["packets"]
        try:
            out = d.set_snmp("hil-community", "hil-name", "hil@example.com", 'HIL bench "A"')
            self.assertIn("SNMP settings saved and active", out)
            # Rate-limit trust earned with the old community is revoked
            self.assertIn("community changed, rate-limit trust cleared", out)

            rc, out = self.snmp("snmpget", "1.3.6.1.2.1.1.5.0", "1.3.6.1.2.1.1.4.0", "1.3.6.1.2.1.1.6.0",
                                community="hil-community")
            self.assertEqual(0, rc, out)
            self.assertIn('1.5.0 = STRING: "hil-name"', out)
            self.assertIn('1.4.0 = STRING: "hil@example.com"', out)
            self.assertIn('1.6.0 = STRING: "HIL bench \\"A\\""', out)

            rc, out = self.snmp("snmpget", "1.3.6.1.2.1.1.5.0", community=before["community"], timeout=1)
            self.assertIn("Timeout", out, "old community must be refused after the change")

            # No reboot happened: the packet counter kept counting instead of restarting at 0
            self.assertGreater(self.snmp_stats()["packets"], packets_before)
        finally:
            d.wait_for_menu(timeout=10)
            d.set_snmp(before["community"], before["sysName"], before["sysContact"], before["sysLocation"])
        rc, out = self.snmp("snmpget", "1.3.6.1.2.1.1.5.0", community=before["community"])
        self.assertIn('STRING: "%s"' % before["sysName"], out)

    def test_snmp_settings_survive_reboot(self):
        d = self.dev
        before = d.status()
        try:
            d.set_snmp(before["community"], "persist-test", "", "")
            d.send("2", expect=r"\(y/n\): $")                  # DHCP + reboot, keeps other settings
            d.send("y", expect=r"Rebooting", timeout=10)
            d.reconnect_after_reboot()
            self.assertEqual("persist-test", d.status()["sysName"])
            rc, out = self.snmp("snmpget", "1.3.6.1.2.1.1.5.0", community=before["community"])
            self.assertIn('STRING: "persist-test"', out)
        finally:
            d.wait_for_menu(timeout=10)
            d.set_snmp(before["community"], before["sysName"], before["sysContact"], before["sysLocation"])

    # ---- performance and robustness ----

    def test_response_time_under_100ms(self):
        times = []
        for i in range(30):
            resp, secs = raw_get(self.ip, 1000 + i)
            self.assertIsNotNone(resp, "no response to request %d" % i)
            self.assertEqual(1000 + i, response_request_id(resp), "request id not echoed")
            times.append(secs * 1000)
        median, worst = statistics.median(times), max(times)
        print("\n    SNMP round trip: median %.1f ms, max %.1f ms" % (median, worst))
        self.assertLess(worst, 100.0, ".clinerules: SNMP requests must be handled within 100 ms")

    def test_survives_malformed_packet_flood(self):
        # The core's UDP queue holds 5 packets, so most of each burst is dropped
        # before the agent; what matters is that the agent keeps working.
        before = self.snmp_stats()
        packets = garbage_packets(300)
        for i in range(0, len(packets), 20):   # bursts of 20
            send_raw(self.ip, packets[i:i + 20])
            time.sleep(0.05)
        time.sleep(2.5)                         # let the queue drain and the rate limiter refill
        answered = any(raw_get(self.ip, 77 + k, timeout=0.5)[0] is not None for k in range(3))
        self.assertTrue(answered, "agent stopped answering after malformed packets")
        after = self.snmp_stats()
        self.assertGreater(after["malformed"], before["malformed"], "flood never reached the agent")
        self.assertGreater(after["responses"], before["responses"], "probe response not counted")

    # ---- security: rate limiting and access log ----

    def test_rate_limit_caps_one_source_and_recovers(self):
        # 50 requests/s per source with a burst of 100. Send as fast as replies come back for 3 s.
        time.sleep(2.5)                          # start with a full bucket
        before = self.dev.status()["rateLimited"]
        answered = unanswered = 0
        start = time.time()
        while time.time() - start < 3.0:
            resp, _ = raw_get(self.ip, 7000 + answered + unanswered, timeout=0.05)
            if resp is None:
                unanswered += 1
            else:
                answered += 1
        elapsed = time.time() - start
        print("\n    rate limit: %d answered, %d dropped in %.1f s" % (answered, unanswered, elapsed))
        expected = 100 + 50 * elapsed
        self.assertGreater(unanswered, 0, "nothing was rate limited")
        self.assertLess(answered, expected * 1.15, "more answered than the limit allows")
        self.assertGreater(answered, expected * 0.7, "far fewer answered than the limit allows")

        st = self.dev.status()
        self.assertGreater(st["rateLimited"], before)
        entries = [e for e in self.dev.access_log() if e[1] == "rate limited"]
        self.assertTrue(entries, "rate limiting not in the access log")

        time.sleep(2.5)                          # bucket refills
        self.assertIsNotNone(raw_get(self.ip, 1, timeout=0.5)[0], "source still blocked after refill")

    def test_access_log_lists_rejected_requests_with_source(self):
        pc = local_ip_towards(self.ip)
        bad = bytearray(GET_SYSDESCR)
        bad[7:13] = b"wrongc"
        send_raw(self.ip, [bytes(bad)])
        send_raw(self.ip, [v3_packet()])
        time.sleep(0.3)
        log = self.dev.access_log()
        events = {(ip, ev) for ip, ev, _ in log}
        self.assertIn((pc, "bad community"), events, log)
        self.assertIn((pc, "bad version"), events, log)
        newest = log[0]
        self.assertEqual((pc, "bad version"), newest[:2], "newest entry must come first")

    def test_set_request_is_logged(self):
        self.snmp("snmpset", "1.3.6.1.2.1.1.5.0", "s", "x")
        log = self.dev.access_log()
        self.assertEqual("set rejected", log[0][1], log)

    def test_five_simultaneous_requests_are_all_answered(self):
        # Documented limit: the core queues 5 UDP packets (UdpContext::rxBufMaxDepth + 1).
        # Warm up first: if the device's ARP entry for this PC has expired, lwIP holds
        # only one reply while it resolves the address and drops the others.
        self.assertIsNotNone(raw_get(self.ip, 499)[0], "warm-up request not answered")
        with socket.socket(socket.AF_INET, socket.SOCK_DGRAM) as s:
            s.settimeout(0.5)
            for i in range(5):
                pkt = bytearray(GET_SYSDESCR)
                struct.pack_into(">I", pkt, REQUEST_ID_OFFSET, 500 + i)
                s.sendto(bytes(pkt), (self.ip, 161))
            ids = set()
            try:
                while True:
                    ids.add(response_request_id(s.recvfrom(2048)[0]))
            except socket.timeout:
                pass
        self.assertEqual({500, 501, 502, 503, 504}, ids)

    def test_oversized_packet_is_ignored(self):
        send_raw(self.ip, [b"\x30" + b"\x00" * 1499])
        resp, _ = raw_get(self.ip, 78)
        self.assertIsNotNone(resp)

    # ---- mains (needs a mains switch, see mains_switch.py) ----

    @skip_without_switch
    def test_mains_loss_and_restore_visible_over_snmp(self):
        def mains():
            rc, out = self.snmp("snmpget", ENTERPRISE + ".1.0", ENTERPRISE + ".2.0", ENTERPRISE + ".3.0")
            status = int(re.search(r"63050\.1\.0 = INTEGER: (\d)", out).group(1))
            changes = int(re.search(r"Counter32: (\d+)", out).group(1))
            last = int(re.search(r"63050\.3\.0 = Timeticks: \((\d+)\)", out).group(1))
            return status, changes, last

        status, changes, last = mains()
        self.assertEqual(1, status, "mains must be on when the test starts")

        def wait_for(expected):
            deadline = time.time() + 60
            while time.time() < deadline:
                s = mains()
                if s[0] == expected:
                    return s
                time.sleep(0.5)
            self.fail("mainsPowerStatus never became %d" % expected)

        switch = get_switch()
        try:
            switch.off()
            off = wait_for(0)
            switch.on()
            on = wait_for(1)
        finally:
            switch.restore()
        self.assertEqual(changes + 1, off[1])
        self.assertGreater(off[2], last)
        self.assertEqual(changes + 2, on[1])
        self.assertGreater(on[2], off[2])

    @skip_without_switch
    def test_short_outage_between_polls_is_seen_in_the_change_counter(self):
        # A manager polling every few minutes misses a short outage in mainsPowerStatus;
        # mainsPowerChanges must still show it
        switch = get_switch()
        if not switch.automatic:
            self.skipTest("needs the automatic switch for a short outage")

        def changes():
            rc, out = self.snmp("snmpget", ENTERPRISE + ".1.0", ENTERPRISE + ".2.0")
            return (int(re.search(r"63050\.1\.0 = INTEGER: (\d)", out).group(1)),
                    int(re.search(r"Counter32: (\d+)", out).group(1)))

        status, before = changes()
        self.assertEqual(1, status, "mains must be on when the test starts")
        try:
            switch.off()
            switch.on()        # each switch takes about a second: an outage of ~1 s
        finally:
            switch.restore()
        def counted_twice():
            s = changes()
            return s if s[1] >= before + 2 else None
        status, after = wait_until(counted_twice, 10) or changes()
        self.assertEqual(1, status)
        self.assertEqual(before + 2, after, "the outage must count as one loss and one restore")


if __name__ == "__main__":
    unittest.main(verbosity=2)
