TheKingOfChaos/RF-UPS-Monitor/(commit log)

2026-10-16 Add lwIP Ethernet, serial network menu, power-safe settings and tests
    - Use the Arduino-Pico core's Wiznet5500lwIP driver for DHCP/static IP
    instead of the incomplete custom stack (now excluded via lib_ignore)
    - Serial menu (src/cli.cpp) to show status, switch to DHCP or set a
    validated static IP; saves and reboots on confirm
    - Settings: A/B copies with a save sequence number, read-back verification,
    fallback to the previous copy when the newest is corrupt; v1 files load
    - Split pure logic into host-testable libs: netconfig, settings_codec
    - Tests: native (39), on-device embedded (12), HIL serial menu (Python)
    - Testing rules in .clinerules, docs/TESTING.md, CLAUDE.md, README/TODO
    up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
    [cli.cpp, cli.h, device.py, factory_reset.cpp, factory_reset.h, main.cpp, pins.h]
2026-10-16 Remove obsolete custom W5500/network stack and its tests
    The firmware uses the core's lwIP W5500 driver. The old libraries and
    the tests that targeted them (which no longer compiled) are deleted,
    along with the lib_ignore entries that excluded them.
2026-10-16 Boot without waiting for DHCP, report connection state
    - setup() no longer waits up to 15 s for a lease; lwIP obtains it in the
    background and loop() reports when the address is obtained, changes
    or is lost
    - No lease: keep retrying DHCP, no fallback address (avoids IP conflicts)
    - Status screen shows a State line: connected / waiting for lease /
    no link / W5500 not detected
    - HIL: test that the menu appears before the lease, test the state line,
    and wait_connected() for tests that need the network
    - README, TODO and TESTING updated; static IP marked verified
    [device.py, main.cpp, test_serial_menu.py]
2026-10-16 Add mains power monitoring on GPIO27 (core 1)
    - lib/power_monitor: pure debouncer (5 ms, detection within 10 ms)
    - lib/mains_input: GPIO27 sampled at 1 kHz on core 1 (setup1/loop1),
    internal pull-down, seqlock with memory barriers for the hand-over to
    core 0
    - Serial log on every loss/restore, mains line on the status screen
    - Tests: native debouncer (10), on-device sampler (5, incl. raw signal
    diagnostic), HIL status line and manual loss/restore (passed with real
    mains)
    - include/ added to the include path so libraries can use pins.h
    - README, TODO, TESTING, CLAUDE.md updated
2026-10-16 Add SNMP v1 agent, traps, rate limiting, access log, non-blocking reset, CI
    SNMP (TODO 2):
    - lib/snmp_ber: strict, bounds-checked BER codec and OIDs, byte-exact
    against net-snmp, clean under ASan/UBSan incl. every single-byte
    corruption
    - lib/snmp_agent: message parsing/responses, MIB (system group +
    enterprise 63050 mains objects), Get/GetNext/Set handling, v1 traps
    (coldStart, authenticationFailure, mainsPowerLost/Restored)
    - src/snmp_service.cpp: UDP 161, traps to the configured destination
    - mibs/RF-UPS-MONITOR-MIB.txt validated with snmptranslate; docs/MIB.md
    - sysName/sysContact/sysLocation/community/trap destination configurable
    in menu option 4, active without reboot
    Secur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
    [cli.cpp, device.py, factory_reset.cpp, factory_reset.h, main.cpp, snmp_service.cpp]
2026-10-16 Add global SNMP rate limit so spoofed sources cannot bypass it
    The per-source limiter tracks 8 sources and gives a new source a full
    bucket, so rotating or spoofed UDP source addresses could reset it and
    get unlimited requests through. A global bucket (100/s, burst 200),
    shared by all requests, now caps the total. Requests refused by their
    own source bucket do not take global tokens, so one flooding source
    cannot starve the others. Found by automated security review.
    [snmp_service.cpp, snmp_service.h, test_main.cpp]
2026-10-16 Trust authenticated SNMP sources and fix rate limiter freeze
    - Sources that sent the right community are marked trusted: they skip
    the shared global bucket and are evicted from the source table last,
    so a flood from spoofed addresses can no longer starve real managers
    - Refill uses unsigned elapsed time: an idle gap of more than 2^31 ms
    (~24.8 days) no longer looks negative and freezes a bucket
    - Found by automated security review
    [snmp_service.cpp, snmp_service.h, test_main.cpp]
2026-10-16 Bound SNMP rate-limit trust and revoke it on community change
    Trust is earned with the community, which may be the default "public"
    or sniffed (SNMPv1 is clear text), so it must not remove all limits:
    - Trusted sources share their own bucket (200/s, burst 400) instead of
    having no global cap
    - At most 4 sources are trusted at once
    - Trust expires after 10 minutes without requests
    - Changing the community in the menu clears all trust
    - Docs recommend changing the community from "public"
    Found by automated security review.
2026-10-16 Expire idle SNMP trust across the whole source table
    Trust expiry was only checked when the same source sent again, so
    managers that went quiet kept their trust slots and eviction
    protection forever; after four idle managers no new one could become
    trusted. Every allow() now sweeps the table and clears expired trust
    first. Found by automated security review.
2026-10-17 Add SNMPv2c: GetBulk, v2c exceptions and errors, v2c traps
    - Requests are answered in their own version (v1 or v2c); SNMPv3 is
    dropped and counted. v1 behaviour is unchanged
    - v2c Get/GetNext report noSuchObject, noSuchInstance and endOfMibView
    per varbind; Set returns notWritable/noCreation; tooBig has an empty
    varbind list
    - GetBulkRequest with non-repeaters/max-repetitions, early stop at
    endOfMibView and truncation to fit (max 64 varbinds)
    - SNMPv2-Trap encoding, byte-exact against net-snmp; trap version
    (v1/v2c, default v2c) in settings and menu option 4
    - .clinerules: SNMP v1 and v2c, no v3
    - Tests: native (236), net-snmp check (41), HIL in v1 and v2c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
    [cli.cpp, device.py, snmp_service.cpp, snmp_tools.py, test_factory_reset.py, test_main.cpp, test_serial_menu.py, test_snmp.py]
2026-10-17 Add IF-MIB interface counters, board temperature and LibreNMS support
    - Counter64 in the BER codec; 64-bit columns hidden from v1 (RFC 3584)
    - lib/if_stats: frame counting and W5500 PHYCFGR decoding (pure, tested)
    - src/net_stats: count frames at the lwIP netif, read link/speed from
    the PHY every 500 ms, log link changes
    - ifNumber, ifTable and ifXTable for the Ethernet port
    - boardTemperature (63050.4) from the RP2040 sensor, in the MIB file
    - GetBulk replies capped at 16 varbinds against reflection; GetBulk
    does not grant rate-limit trust
    - Status screen shows temperature, link and traffic
    - LibreNMS OS detection/discovery definitions and docs/LIBRENMS.md
    - sysDescr and boot banner use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
2026-10-17 Release 1.0.1: count receive discards, errors and unknown protocols
    - ifInDiscards: CountingW5500 hides the driver's discardFrame(), which
    LwipIntfDev calls exactly when no pbuf is free for a received frame
    - ifInErrors: frames shorter than the Ethernet header or over 1514 bytes
    - ifInUnknownProtos: EtherTypes lwIP does not handle (IPv6 while off,
    LLDP, STP, VLAN); such frames no longer count as delivered packets
    - "Ethernet drops" line on the status screen
    - Native, net-snmp and HIL tests; docs, TODO and CHANGELOG updated
    [cli.cpp, device.py, main.cpp, net_stats.cpp, net_stats.h, test_main.cpp, test_snmp.py]
2026-10-17 Test the LibreNMS definitions in a real LibreNMS, fix temperature low limit
    Checked with LibreNMS 26.9.1 in Docker against the device: OS, version
    and hardware detected, mains state, temperature and change-count
    sensors created, eth0 polled with rates, mains trap logged as unhandled.
    LibreNMS set the temperature low limit 10 C below the first reading
    (29.4 C), which would alarm when the room cools; set it to -20 C.
    Add librenms/test/compose.yml to repeat the check.
2026-10-17 Automate the mains HIL tests with an IKEA Dirigera smart plug
    With RFUPS_MAINS_SWITCH=dirigera (hub IP, outlet name and token path from
    environment variables) the mains tests switch the outlet feeding the
    mains detector themselves, and always switch it back on. The manual mode
    (RFUPS_MANUAL_MAINS=1) still works.
    First runs with real mains: loss/restore over serial and SNMP and the
    mainsPowerLost/Restored traps in v1 and v2c all pass. New test: a ~1 s
    outage between two reads still shows in mainsPowerChanges.
    A real mains cut also raised and cleared LibreNMS's "State Sensor
    Critical" alert in the Docker LibreNMS.
2026-10-17 Release 1.0.2: documentation update
    - README: documentation overview, a real status screen example, trap
    settings in the settings file description, current version
    - Version references in docs/MIB.md and docs/LIBRENMS.md
    - CHANGELOG entry for 1.0.2 (LibreNMS low-limit fix, LibreNMS test
    setup, automated mains tests); firmware version 1.0.2
2026-10-17 Add Excalidraw diagrams of the project
    Six editable .excalidraw diagrams in docs/diagrams/ with SVG exports:
    system overview, firmware architecture, SNMP request flow, mains flow,
    settings storage and test layers. Shown in the README and TESTING.md.
    make_diagrams.py generates the .excalidraw files (boxes with bound
    text, arrows bound to their shapes); render_svg.sh exports them with
    Excalidraw's own exportToSvg in a Playwright Docker container and
    embeds the Virgil font so they render the same on GitHub.
2026-10-17 Release 2.0.0: configuration web page with login
    - Web page on TCP 80 (user admin): status, DHCP/static IP (saves and
    restarts), SNMP community (active immediately), restart, log out
    - lib/web_ui (pure, host tested): bounded incremental HTTP parser,
    form/cookie helpers, SHA-256, salted iterated password hash checked
    in steps, sessions with CSRF tokens, login throttle, pages
    - src/web_service: non-blocking connection handling; a slow client,
    page loads or a hashed login never delay SNMP beyond 100 ms
    - Random per-device default password, shown only on the serial status
    screen; own password via new serial menu option 6 (masked input),
    stored as a hash in the new optional settings f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
2026-10-17 README: use a made-up example for the default web password
    The example was the real default password of the development device.
2026-10-17 Release 2.0.1: serial option to replace the default web password
    - Serial menu option 7 generates a new random device default web
    password (saved and read back), for when the default became known;
    the old one stops working at once and browsers using it are logged out
    - An own password set with option 6 stays in use
    - HIL tests for option 7; docs and CHANGELOG
    [cli.cpp, device.py, test_serial_menu.py, test_web.py, web_service.cpp, web_service.h]
2026-10-17 Release 2.2.0: trap destination from DHCP, web on/off, logo
    - Trap destination "dhcp" (menu option 4): the device asks for DHCP
    option 224 by appending it to option 55 of its own DISCOVER/REQUEST
    (in place, in lwIP's padding, UDP checksum fixed) and reads it from
    DHCPACKs for its MAC and current lease; works with any server that has
    option 224 configured. Verified against Kea 2.2.0 in Docker (sends 224
    only to the edited frames) and the LAN server (lease kept)
    - New pure library lib/dhcp_option, tested with frames captured from the
    device and from Kea, every truncation and single-byte corruption
    - Web interface on/off: serial option 8 and "Turn off..." on the page
    (with confirm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
    [cli.cpp, device.py, hostname.cpp, hostname.h, main.cpp, make_diagrams.py, net_stats.cpp]
2026-10-17 Accept DHCP option 224 only from ACKs lwIP accepted
    A forged "ACK" for the device's MAC and IP from any LAN host could set
    the trap destination, and traps carry the SNMP community. Option 224 is
    now taken only if lwIP was waiting for an ACK, the frame has lwIP's
    transaction id and server id, and lwIP became bound by that frame.
    Ignored frames are counted on the status screen.
    - dhcpReadAck() returns xid and server id (DhcpAckInfo); native tests
    check them against the captured device/Kea exchange
    - HIL: a forged ACK with option 224 sent from the PC is ignored
    - docs/MIB.md: remaining risk of a rogue DHCP server
    Found by an automated security review of the 2.2.0 commit.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
2026-10-17 Release 2.3.0: IPv6 (dual stack)
    - IPv4 + IPv6: link-local and SLAAC addresses; SNMP, web page and mDNS
    over IPv6; addresses on the status screen and the web page
    - Rate limiter, trust and access log keyed per full source address
    (SourceKey, 128 bits, src/source_key.h); IPv4-mapped = IPv4, ::/32
    dropped. Not per /64: all LAN hosts share one /64, so a manager's trust
    would have passed to its neighbours (found in review)
    - Fixes found while bringing IPv6 up, each with a test:
    - lwIP timer pool sized without mDNS ran empty -> lwIP panic:
    MEMP_NUM_SYS_TIMEOUT +12
    - core UdpContext marks its helper pbuf with flags 0xFF (includes
    PBUF_FLAG_IS_CUSTOM); with IPv6 fragmentation cu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
    [cli.cpp, device.py, diag.cpp, diag.h, main.cpp, make_diagrams.py, net_stats.cpp]
2026-10-17 Release 2.4.0: static IPv6 address and gateway
    - One static IPv6 address (/64) and an optional gateway, set with serial
    menu option 9 or the new IPv6 card on the web page; saving reboots
    - Added next to link-local and SLAAC (not instead), with duplicate
    address detection; status screen marks it (static) / (DUPLICATE ...)
    - Gateway: lwIP hook LWIP_HOOK_ND6_GET_GW (include/lwip_hooks.h, weak so
    builds without src/ still link); without it the advertised routers
    are used. LWIP_IPV6_NUM_ADDRESSES 3 -> 4
    - lib/netconfig: parseIPv6, formatIPv6 (RFC 5952), validateStaticIPv6;
    the access log uses the same formatter
    - Settings: optional ipv6Address / ipv6Gateway, older files load
    unchanged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
    [cli.cpp, device.py, ipv6_static.cpp, ipv6_static.h, lwip_hooks.h, main.cpp, make_diagrams.py]
2026-10-17 Docs: web request flow and network addresses diagrams, LibreNMS over IPv6
    - docs/diagrams: web-request-flow and network-addresses (generated by
    make_diagrams.py, rendered SVGs), linked from the README; settings
    diagram says serial menu or web page
    - docs/LIBRENMS.md: adding the device with transport udp6; not yet tried
    in LibreNMS (the WSL Docker setup has no IPv6 route to the LAN)
    - README: LibreNMS IPv6 claim corrected to what is tested
    [make_diagrams.py]
2026-10-17 LibreNMS over IPv6 tested: IPv6 on the test compose network, docs
    - librenms/test/compose.yml: enable_ipv6 on the default network
    - docs/LIBRENMS.md: udp6 checked with LibreNMS 26.9.1 (detected as
    RF-UPS-Monitor, sensors and port polled over IPv6); WSL needs mirrored
    networking; duplicate sysName note
    - README: IPv6 LibreNMS line
2026-10-18 Hardware: carrier PCB for the W5500-EVB-Pico-PoE, documented
    - hardware/pico-poe-mains-carrier: KiCad 10 project (generated by
    tools/generate.py), isolated 230 VAC detector (LTV-814S, 74LVC1G14) on
    GP27, LEDs, TMP1075 on I2C0, DRC isolation rules, JLCPCB fab files,
    STEP/GLB models, renders; KiCad local history ignored
    - README: carrier board section, how it maps to the firmware, pin table
    (I2C0), safety, documentation table, project structure
    - TODO: hardware section (first boards, TMP1075, no factory reset button
    on GP22 - module buttons are BOOTSEL/RUN, mains loss 30-50 ms vs 10 ms)
    - CLAUDE.md layout, CHANGELOG Unreleased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
    [W5500-EVB-Pico-PoE_V1.1.step, pico-poe-mains-carrier-bom.csv, pico-poe-mains-carrier-carrier-only.step, pico-poe-mains-carrier-headers.step, pico-poe-mains-carrier.kicad_pcb, pico-poe-mains-carrier.kicad_sch, pico-poe-mains-carrier.step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]
2026-10-18 Hardware: carrier board v1.1 - fuse, factory reset button, holes, logo
    - F1 T100mA 250VAC (Schurter UMT 250, 3403.0156.11, no LCSC part) after
    the L terminal; the divider is R1 in L and R2-R4 in N, one series loop
    through F1
    - SW1 (XKB TS-1187A, LCSC C318884) from GP22 to GND next to H1, so the
    firmware's 10 s factory reset works on the carrier
    - I2C pull-ups renumbered R8/R9 (no gap after R7)
    - H4/H5 M3 holes under the module for mounting the carrier when the
    module is on headers (project footprint without courtyard)
    - Silkscreen: RF logo (logo/, flattened by generate.py), "RF-UPS-Monitor
    v1.1", "Made by Kenneth Foli Jørgensen 2026"; title blocks updated
    - render.sh: male headers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
    [pico-poe-mains-carrier-bom.csv, pico-poe-mains-carrier-carrier-only.step, pico-poe-mains-carrier-headers.step, pico-poe-mains-carrier.kicad_pcb, pico-poe-mains-carrier.kicad_sch, pico-poe-mains-carrier.step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]
2026-10-19 Release 2.4.2: carrier board v1.1, project name RF-UPS-Monitor
    Firmware unchanged apart from the version number.
